thevinufernando/leo-floor-cleaning-robot/README.md

# leo-floor-cleaning-robot
An advanced Autonomous Floor Cleaning Robot.
