thevinufernando/leo-floor-cleaning-robot/docs/initial_basic_plan.jpeg

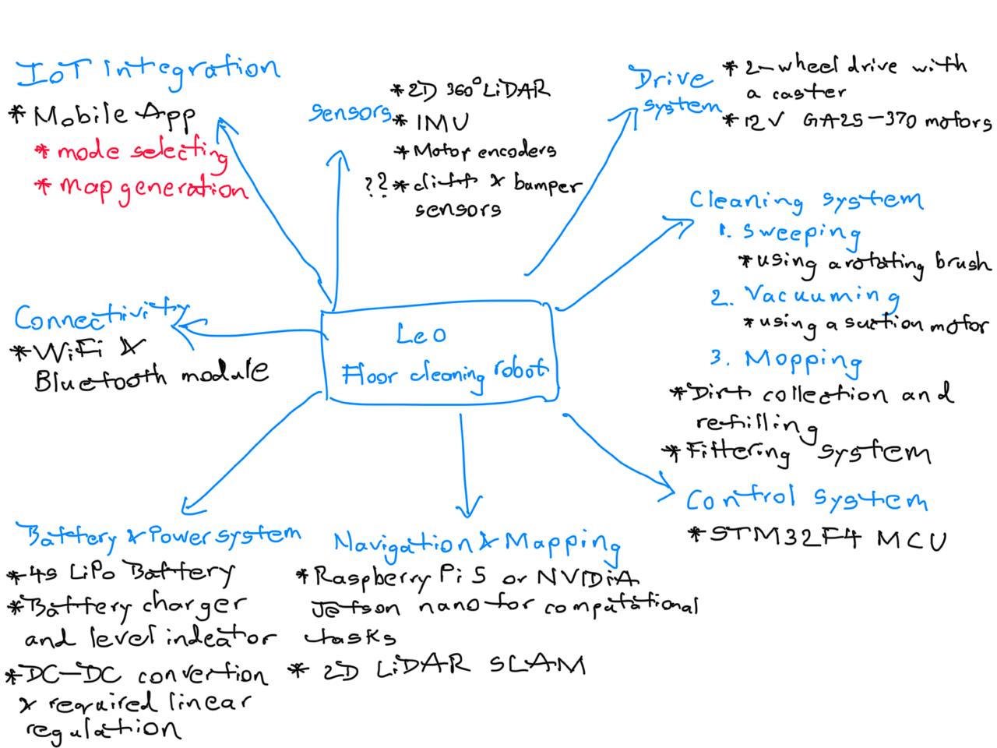
docs/initial_basic_plan.jpeg
