thevinufernando/leo-floor-cleaning-robot/Finalized design files/encloser split/topleft.STEP

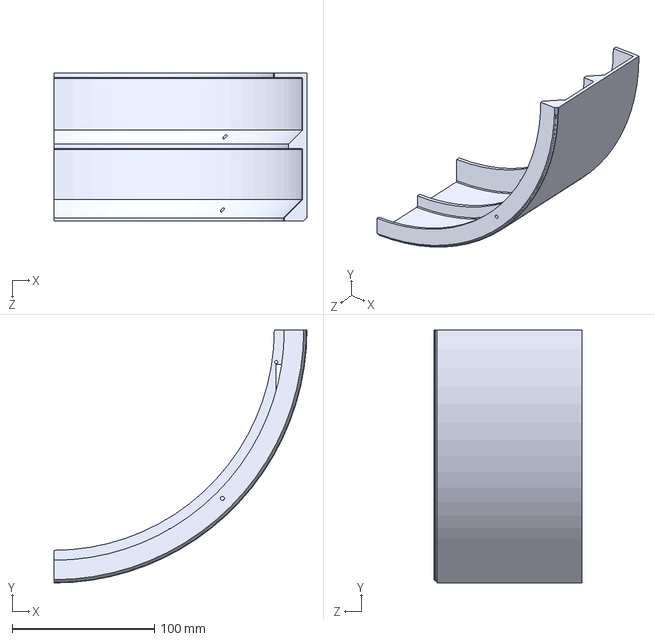
[picture p27: CAD file, 2026-08-20]
Finalized design files/encloser split/topleft.STEP
178.0 x 178.0 x 104.0 mm
