thevinufernando/leo-floor-cleaning-robot/Finalized design files/toplid ring.SLDPRT

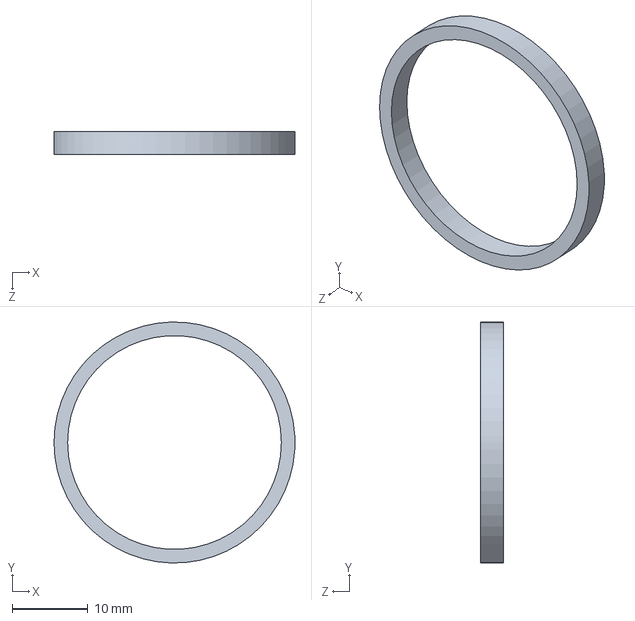
[picture p28: CAD file, 2026-08-20]
Finalized design files/toplid ring.SLDPRT
31.8 x 31.8 x 3.00 mm
