thevinufernando/leo-floor-cleaning-robot/mechanical_designs/Centrifugal Pump Design/Final Product Design/vaccum with base.step

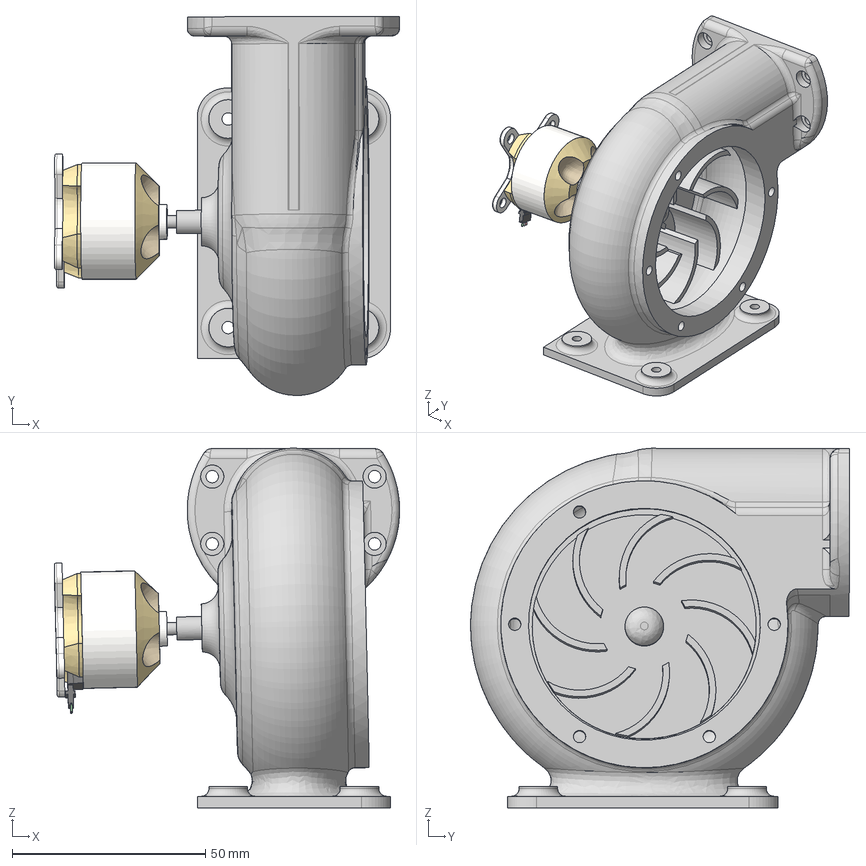
[picture p29: CAD file, 2026-08-04]
mechanical_designs/Centrifugal Pump Design/Final Product Design/vaccum with base.step
89.4 x 98.1 x 93.1 mm
Centrifugal_Pump_Case2
impeller_01
