thevinufernando/leo-floor-cleaning-robot/mechanical_designs/Centrifugal Pump Design/Pump Case Design/Centrifugal_Pump_Case2.SLDPRT

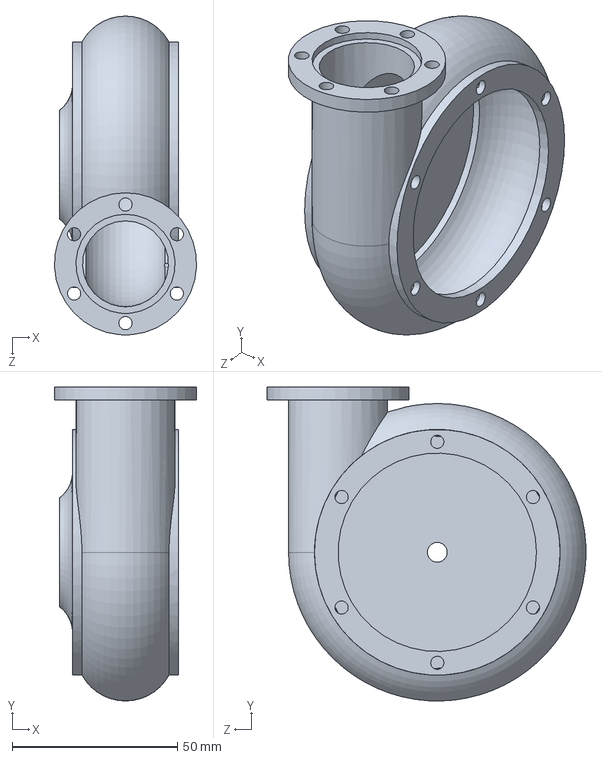
[picture p30: CAD file, 2026-08-06]
mechanical_designs/Centrifugal Pump Design/Pump Case Design/Centrifugal_Pump_Case2.SLDPRT
43.0 x 95.0 x 96.5 mm
