thevinufernando/leo-floor-cleaning-robot/mechanical_designs/Centrifugal Pump/impeller_01.SLDPRT

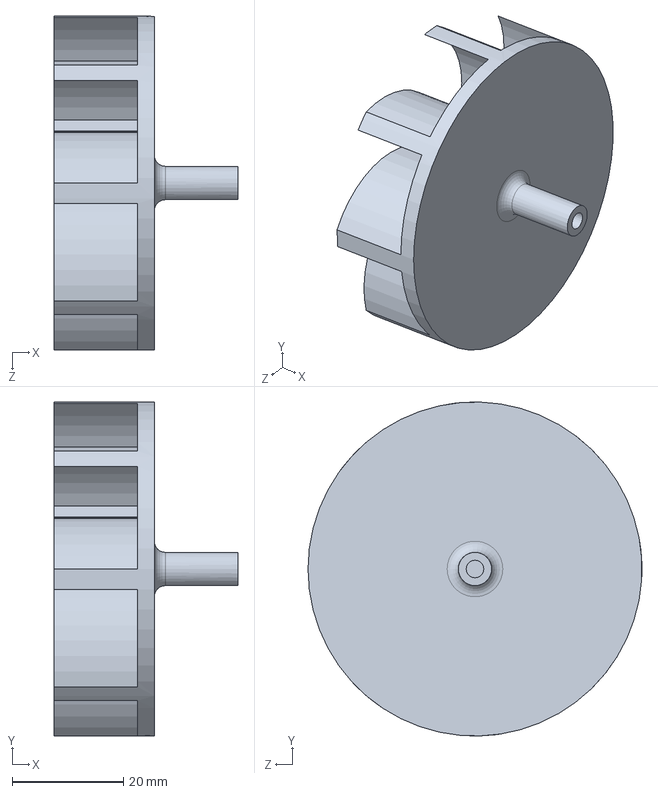
[picture p31: CAD file, 2026-08-04]
mechanical_designs/Centrifugal Pump/impeller_01.SLDPRT
33.0 x 60.0 x 60.0 mm
