thevinufernando/leo-floor-cleaning-robot/Finalized design files/air vent.SLDPRT

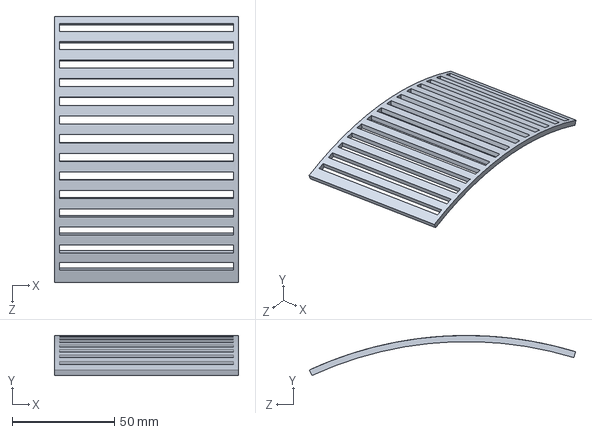
[picture p32: CAD file, 2026-08-20]
Finalized design files/air vent.SLDPRT
89.8 x 19.5 x 130.0 mm
