thevinufernando/leo-floor-cleaning-robot/Finalized design files/encloser split/topright.STEP

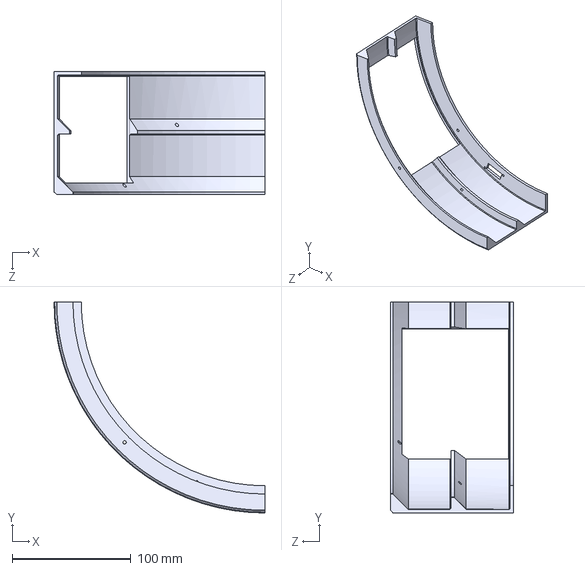
[picture p33: CAD file, 2026-08-20]
Finalized design files/encloser split/topright.STEP
178.0 x 178.0 x 104.0 mm
