thevinufernando/leo-floor-cleaning-robot/mechanical_designs/Centrifugal Pump Design/Pump Case Design/support.SLDPRT

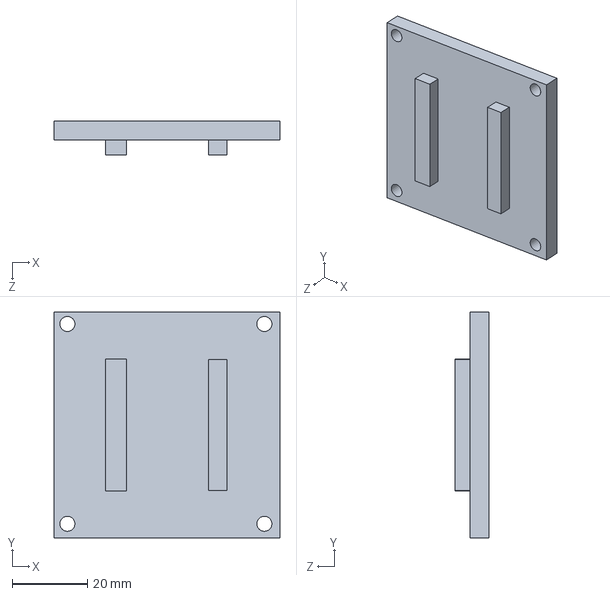
[picture p34: CAD file, 2026-08-06]
mechanical_designs/Centrifugal Pump Design/Pump Case Design/support.SLDPRT
60.0 x 60.0 x 9.00 mm
