thevinufernando/leo-floor-cleaning-robot/mechanical_designs/Centrifugal Pump/vaccum with impeller.STEP

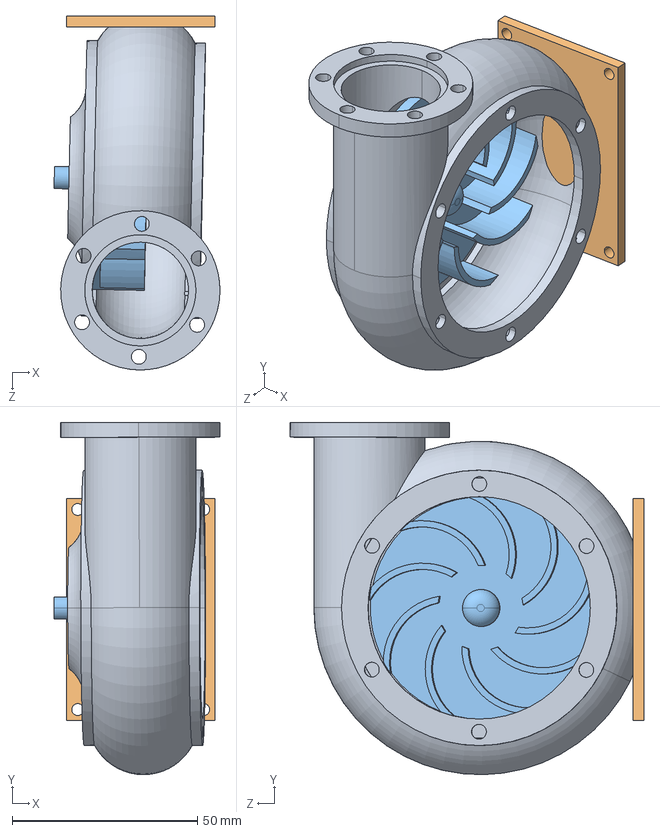
[picture p35: CAD file, 2026-08-04]
mechanical_designs/Centrifugal Pump/vaccum with impeller.STEP
44.8 x 95.1 x 95.5 mm
Centrifugal_Pump_Case2.step
vaccum.step
impeller_02_other blade direction
