thevinufernando/leo-floor-cleaning-robot/mechanical_designs/Centrifugal Pump Design/Pump Case Design/vaccum.STEP

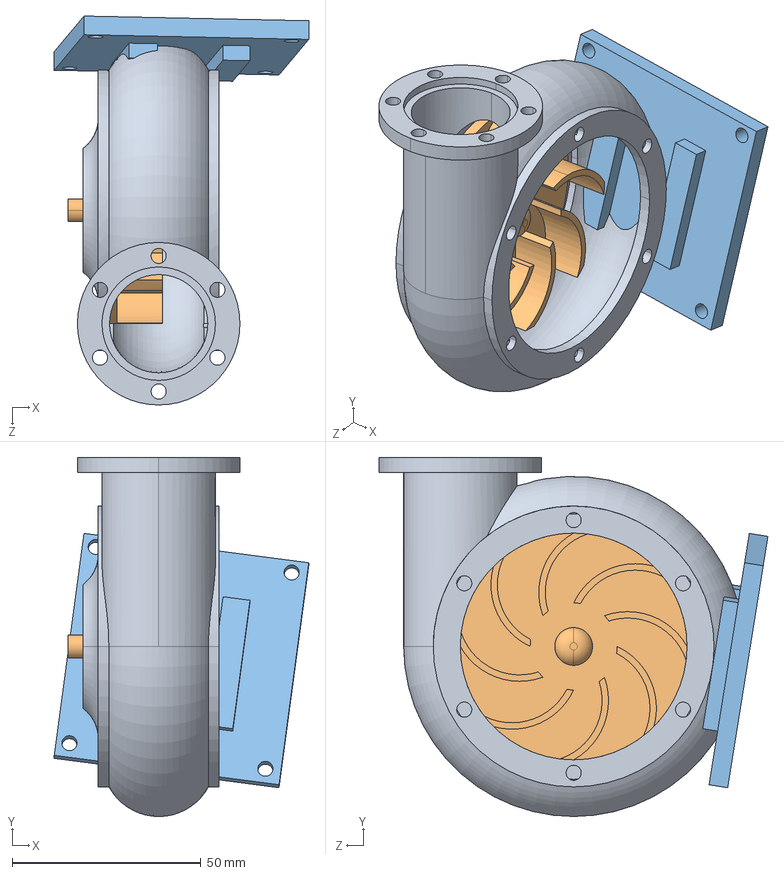
[picture p36: CAD file, 2026-08-06]
mechanical_designs/Centrifugal Pump Design/Pump Case Design/vaccum.STEP
67.4 x 95.0 x 102.9 mm
Centrifugal_Pump_Case2
impeller_01
support
