thevinufernando/leo-floor-cleaning-robot/mechanical_designs/Centrifugal Pump/impeller_02.SLDPRT

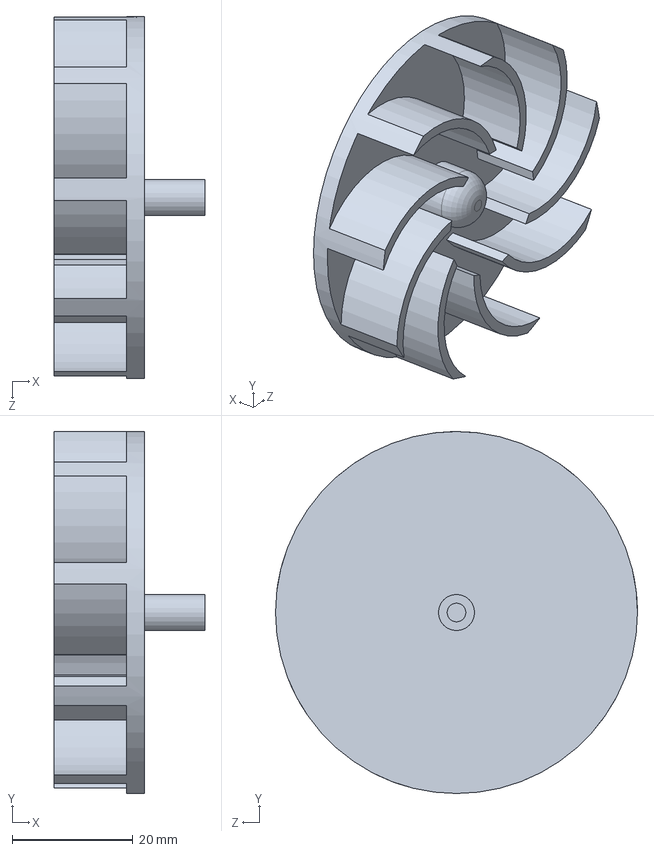
[picture p37: CAD file, 2026-08-04]
mechanical_designs/Centrifugal Pump/impeller_02.SLDPRT
25.0 x 60.0 x 60.0 mm
