thevinufernando/leo-floor-cleaning-robot/Finalized design files/encloser split/vacum and dustbin clip.STEP

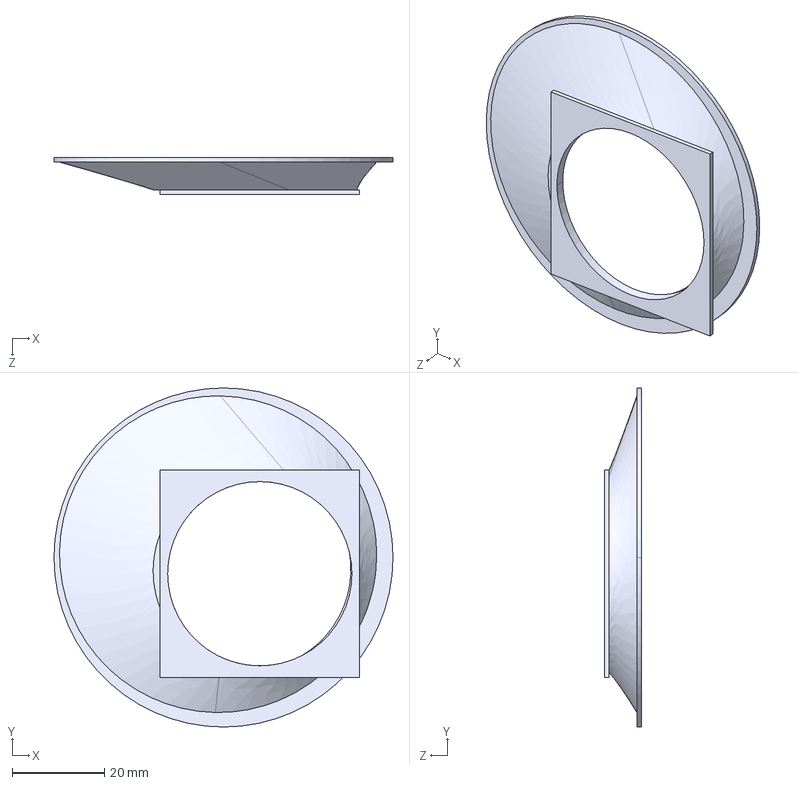
[picture p38: CAD file, 2026-08-20]
Finalized design files/encloser split/vacum and dustbin clip.STEP
73.6 x 73.6 x 8.00 mm
