thevinufernando/leo-floor-cleaning-robot/Finalized design files/encloser split/Sketch4.dxf

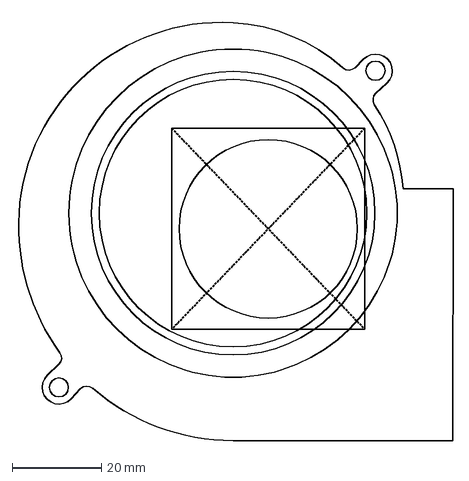
[picture p39: CAD file, 2026-08-20]
Finalized design files/encloser split/Sketch4.dxf
98.0 x 95.1 mm
