thevinufernando/leo-floor-cleaning-robot/Finalized design files/encloser split/vacum and dustbin clip3.STEP

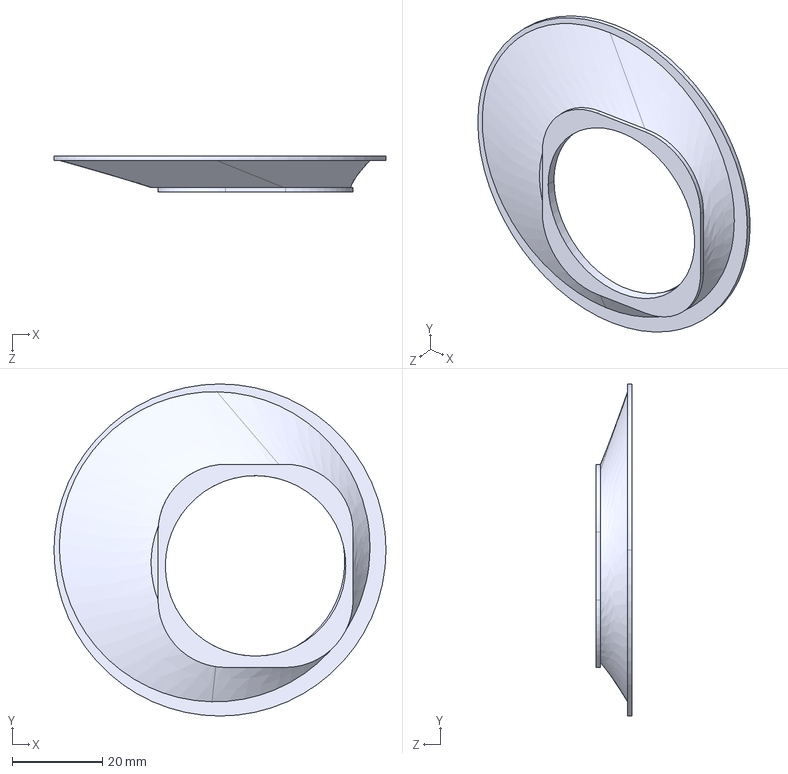
[picture p40: CAD file, 2026-08-20]
Finalized design files/encloser split/vacum and dustbin clip3.STEP
73.6 x 73.6 x 8.00 mm
