thevinufernando/leo-floor-cleaning-robot/Finalized design files/encloser split/vacum and dustbin clip2.STEP

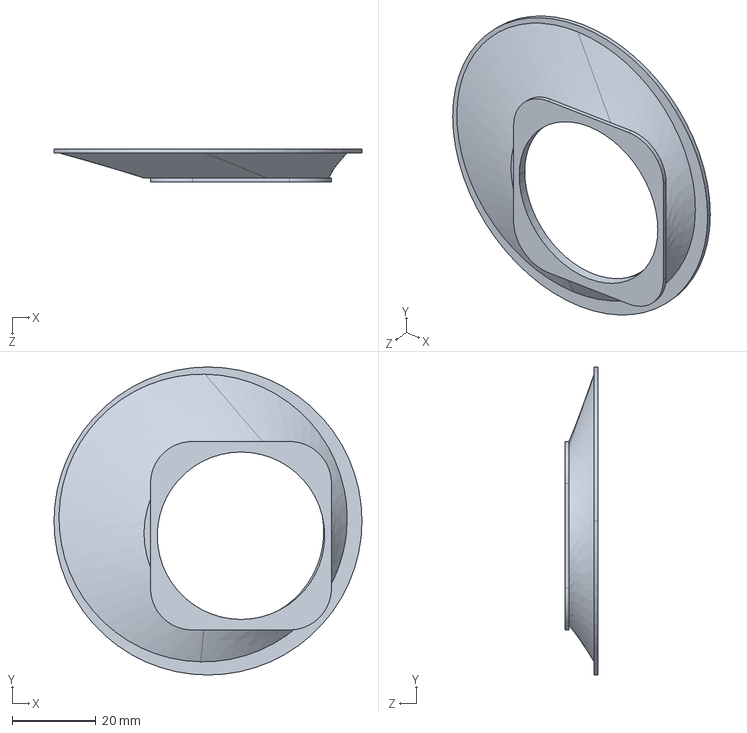
[picture p41: CAD file, 2026-08-20]
Finalized design files/encloser split/vacum and dustbin clip2.STEP
73.6 x 73.6 x 8.00 mm
