thevinufernando/leo-floor-cleaning-robot/mechanical_designs/Centrifugal Pump/vaccum with base with motor.SLDASM

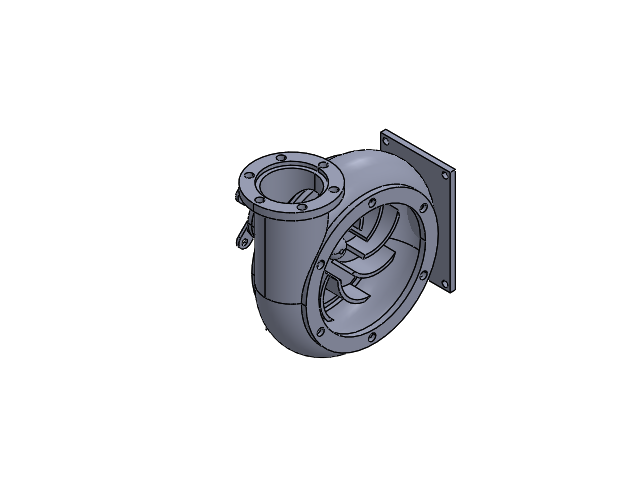
[picture p42: CAD file, 2026-08-04]
mechanical_designs/Centrifugal Pump/vaccum with base with motor.SLDASM
Centrifugal_Pump_Case2.step.STEP
vaccum.step.STEP
impeller_02_other blade direction.STEP
BLDC_A2212_13T_1000KV.STEP
BLDC_A2212_13T_1000KV_MountPlate.STEP
