thevinufernando/leo-floor-cleaning-robot/(list of files, cad)

Other CAD files:
Finalized design files/encloser split/Body8.SLDPRT
Finalized design files/encloser split/Body7.SLDPRT
Finalized design files/encloser split/Body6.SLDPRT
Finalized design files/encloser split/bottomleft.STEP
Finalized design files/encloser split/rightbottom.STEP
Finalized design files/encloser split/bottomleft.SLDPRT
Finalized design files/encloser split/rightbottom.SLDPRT
Finalized design files/encloser split/topleft.SLDPRT
Finalized design files/encloser split/topright.SLDPRT
Finalized design files/encloser split/vacum and dustbin clip.SLDPRT
mechanical_designs/Centrifugal Pump Design/Final Product Design/vaccum with base.iges
mechanical_designs/Centrifugal Pump Design/Pump Case Design/vaccum.SLDASM
