thevinufernando/leo-floor-cleaning-robot/pcb_designs/docs/TPS56637RPAR_5.1V_webench_reports/WBDesign7_Input Transient-3.pdf

## WEBENCH ® Design Report

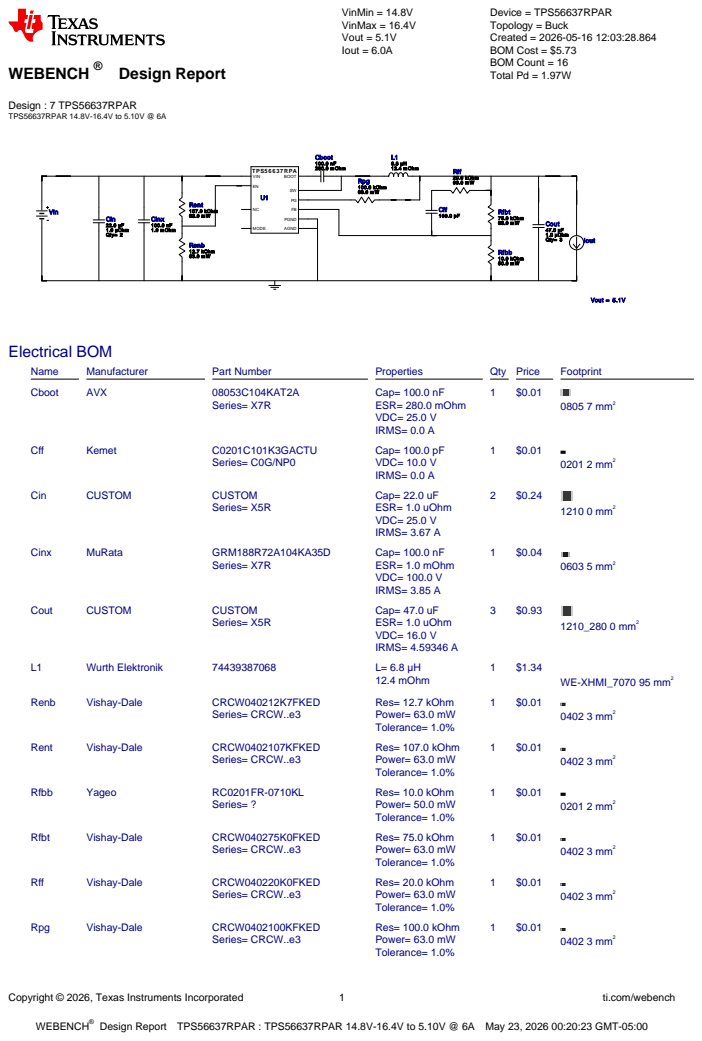
[picture p64: page 1]
Copyright © 2026, Texas Instruments Incorporated; ti.com/webench; WEBENCH®; Design : 7 TPS56637RPAR TPS56637RPAR 14.8V-16.4V to 5.10V @ 6A; VinMin = 14.8V VinMax = 16.4V Vout = 5.1V Iout = 6.0A; Device = TPS56637RPAR Topology = Buck Created = 2026-05-16 12:03:28.864 BOM Cost = $5.73 BOM Count = 16 Total Pd = 1.97W; Vout = 5.1V; Renb 12.7 kOhm 63.0 m W; Rent 107.0 kOhm 63.0 m W Cinx; 100.0 nF 1.0 m Ohm; TPS5 6 6 3 7 RPA; AGND; VIN; BOOT; PGND; MODE; Rpg 100.0 kOhm 63.0 m W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

Design Report TPS56637RPAR : TPS56637RPAR 14.8V-16.4V to 5.10V @ 6A May 23, 2026 00:20:23 GMT-05:00

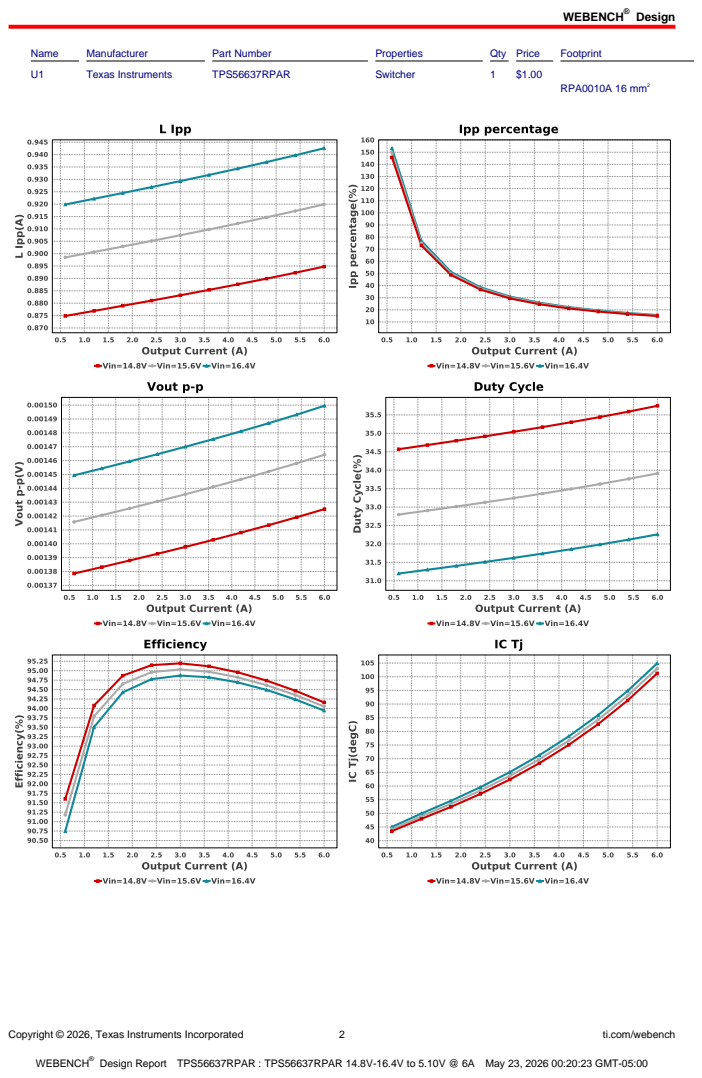
[picture p65: page 2]
Design; Copyright © 2026, Texas Instruments Incorporated; ti.com/webench; Name; Manufacturer; Part Number; Properties; Qty Price; Footprint; Texas Instruments; TPS56637RPAR; Switcher; RPA0010A 16 mm²

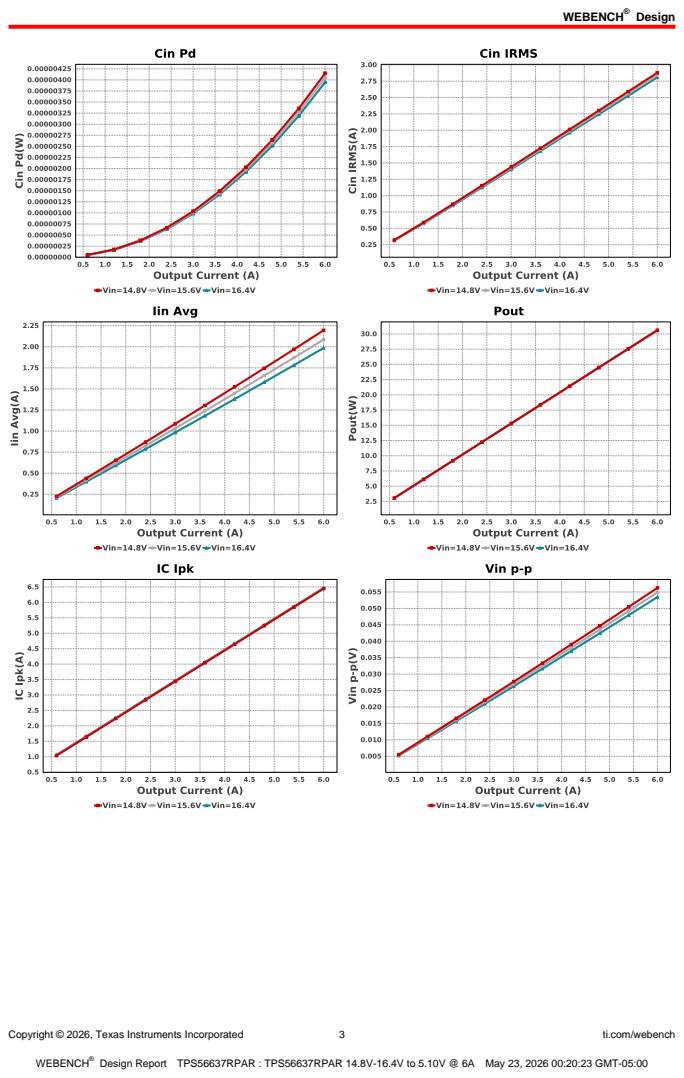
[picture p66: page 3]
Copyright © 2026, Texas Instruments Incorporated; ti.com/webench

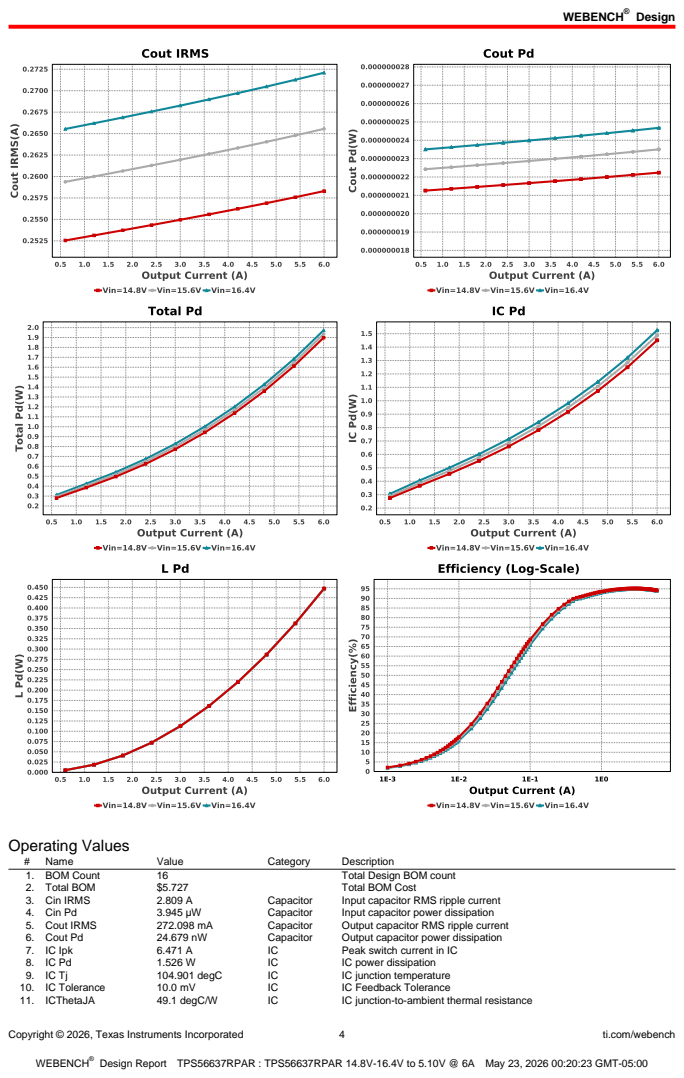
[picture p67: page 4]
Copyright © 2026, Texas Instruments Incorporated; ti.com/webench; Operating Values; Name; Value; Category; Description; 1. BOM Count; Total Design BOM count; 2. Total BOM; Total BOM Cost; 3. Cin IRMS; Capacitor; Input capacitor RMS ripple current; 4. Cin Pd; Input capacitor power dissipation; 5. Cout IRMS; Output capacitor RMS ripple current; 6. Cout Pd; Output capacitor power dissipation; 7. IC Ipk; Peak switch current in IC; IC power dissipation; 104.901 degC; IC junction temperature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

Copyright © 2026, Texas Instruments Incorporated | 5 | ti.com/webench
# | Name | Value | Category | Description

12. Iin Avg | 1.986 A | IC | Average input current
13. Ipp percentage | 15.71 % | Inductor | Inductor ripple current percentage (with respect to average inductor
| | | | current)
14. L Ipp | 942.574 mA | Inductor | Peak-to-peak inductor ripple current
15. L Pd | 447.32 mW | Inductor | Inductor power dissipation
16. Cin Pd | 3.945 µW | Power | Input capacitor power dissipation
17. Cout Pd | 24.679 nW | Power | Output capacitor power dissipation
18. IC Pd | 1.526 W | Power | IC power dissipation
19. L Pd | 447.32 mW | Power | Inductor power dissipation
20. Total Pd | 1.973 W | Power | Total Power Dissipation
21. Duty Cycle | 32.259 % | System
| | | Information | Duty cycle
22. Efficiency | 93.943 % | System
| | | Information | Steady state efficiency
23. FootPrint | 215.0 mm² | System
| | | Information | Total Foot Print Area of BOM components
24. Frequency | 557.247 kHz | System
| | | Information | Switching frequency
25. Iout | 6.0 A | System
| | | Information | Iout operating point
26. Mode | CCM | System
| | | Information | Conduction Mode
27. Pout | 30.6 W | System
| | | Information | Total output power
28. Vin | 16.4 V | System
| | | Information | Vin operating point
29. Vin p-p | 53.478 mV | System
| | | Information | Peak-to-peak input voltage
30. Vout | 5.1 V | System
| | | Information | Operational Output Voltage
31. Vout Actual | 5.1 V | System
| | | Information | Vout Actual calculated based on selected voltage divider resistors
32. Vout Tolerance | 3.479 % | System
| | | Information | Vout Tolerance based on IC Tolerance (no load) and voltage divider resistors if applicable
33. Vout p-p | 1.5 mV | System
| | | Information | Peak-to-peak output ripple voltage

## Design Inputs

Name | Value | Description
Iout | 6.0 | Maximum Output Current
VinMax | 16.4 | Maximum input voltage
VinMin | 14.8 | Minimum input voltage
Vout | 5.1 | Output Voltage
| base_pn | | TPS56637 | Base Product Number
source | DC | Input Source Type
Ta | 30.0 | Ambient temperature


Copyright © 2026, Texas Instruments Incorporated | 6 | ti.com/webench

## Assembly

## Component Testing

Some published data on components in datasheets such as Capacitor ESR and Inductor DC resistance is based on conservative values that will guarantee that the components always exceed the specification. For design purposes it is usually better to work with typical values. Since this data is not always available it is a good practice to measure the Capacitance and ESR values of Cin and Cout, and the inductance and DC resistance of L1 before assembly of the board. Any large discrepancies in values should be electrically simulated in WEBENCH to check for instabilities and thermally simulated in WebTHERM to make sure critical temperatures are not exceeded.

## Soldering Component to Board

If board assembly is done in house it is best to tack down one terminal of a component on the board then solder the other terminal. For surface mount parts with large tabs, such as the DPAK, the tab on the back of the package should be pre-tinned with solder, then tacked into place by one of the pins. To solder the tab town to the board place the iron down on the board while resting against the tab, heating both surfaces simultaneously. Apply light pressure to the top of the plastic case until the solder flows around the part and the part is flush with the PCB. If the solder is not flowing around the board you may need a higher wattage iron (generally 25W to 30W is enough).

## Initial Startup of Circuit

It is best to initially power up the board by setting the input supply voltage to the lowest operating input voltage 14.8V and set the input supply's current limit to zero. With the input supply off connect up the input supply to Vin and GND. Connect a digital volt meter and a load if needed to set the minimum Iout of the design from Vout and GND. Turn on the input supply and slowly turn up the current limit on the input supply.
If the voltage starts to rise on the input supply continue increasing the input supply current limit while watching the output voltage. If the current increases on the input supply, but the voltage remains near zero, then there may be a short or a component misplaced on the board. Power down the board and visually inspect for solder bridges and recheck the diode and capacitor polarities. Once the power supply circuit is operational then more extensive testing may include full load testing, transient load and line tests to compare with simulation results.

## Load Testing

The setup is the same as the initial startup, except that an additional digital voltmeter is connected between Vin and GND, a load is connected between Vout and GND and a current meter is connected in series between Vout and the load. The load must be able to handle at least rated output power + 50% ( 7.5 watts for this design). Ideally the load is supplied in the form of a variable load test unit. It can also be done in the form of suitably large power resistors. When using an oscilloscope to measure waveforms on the prototype board, the ground leads of the oscilloscope probes should be as short as possible and the area of the loop formed by the ground lead should be kept to a minimum. This will help reduce ground lead inductance and eliminate EMI noise that is not actually present in the circuit.

## WEBENCH® Electrical Simulation Report

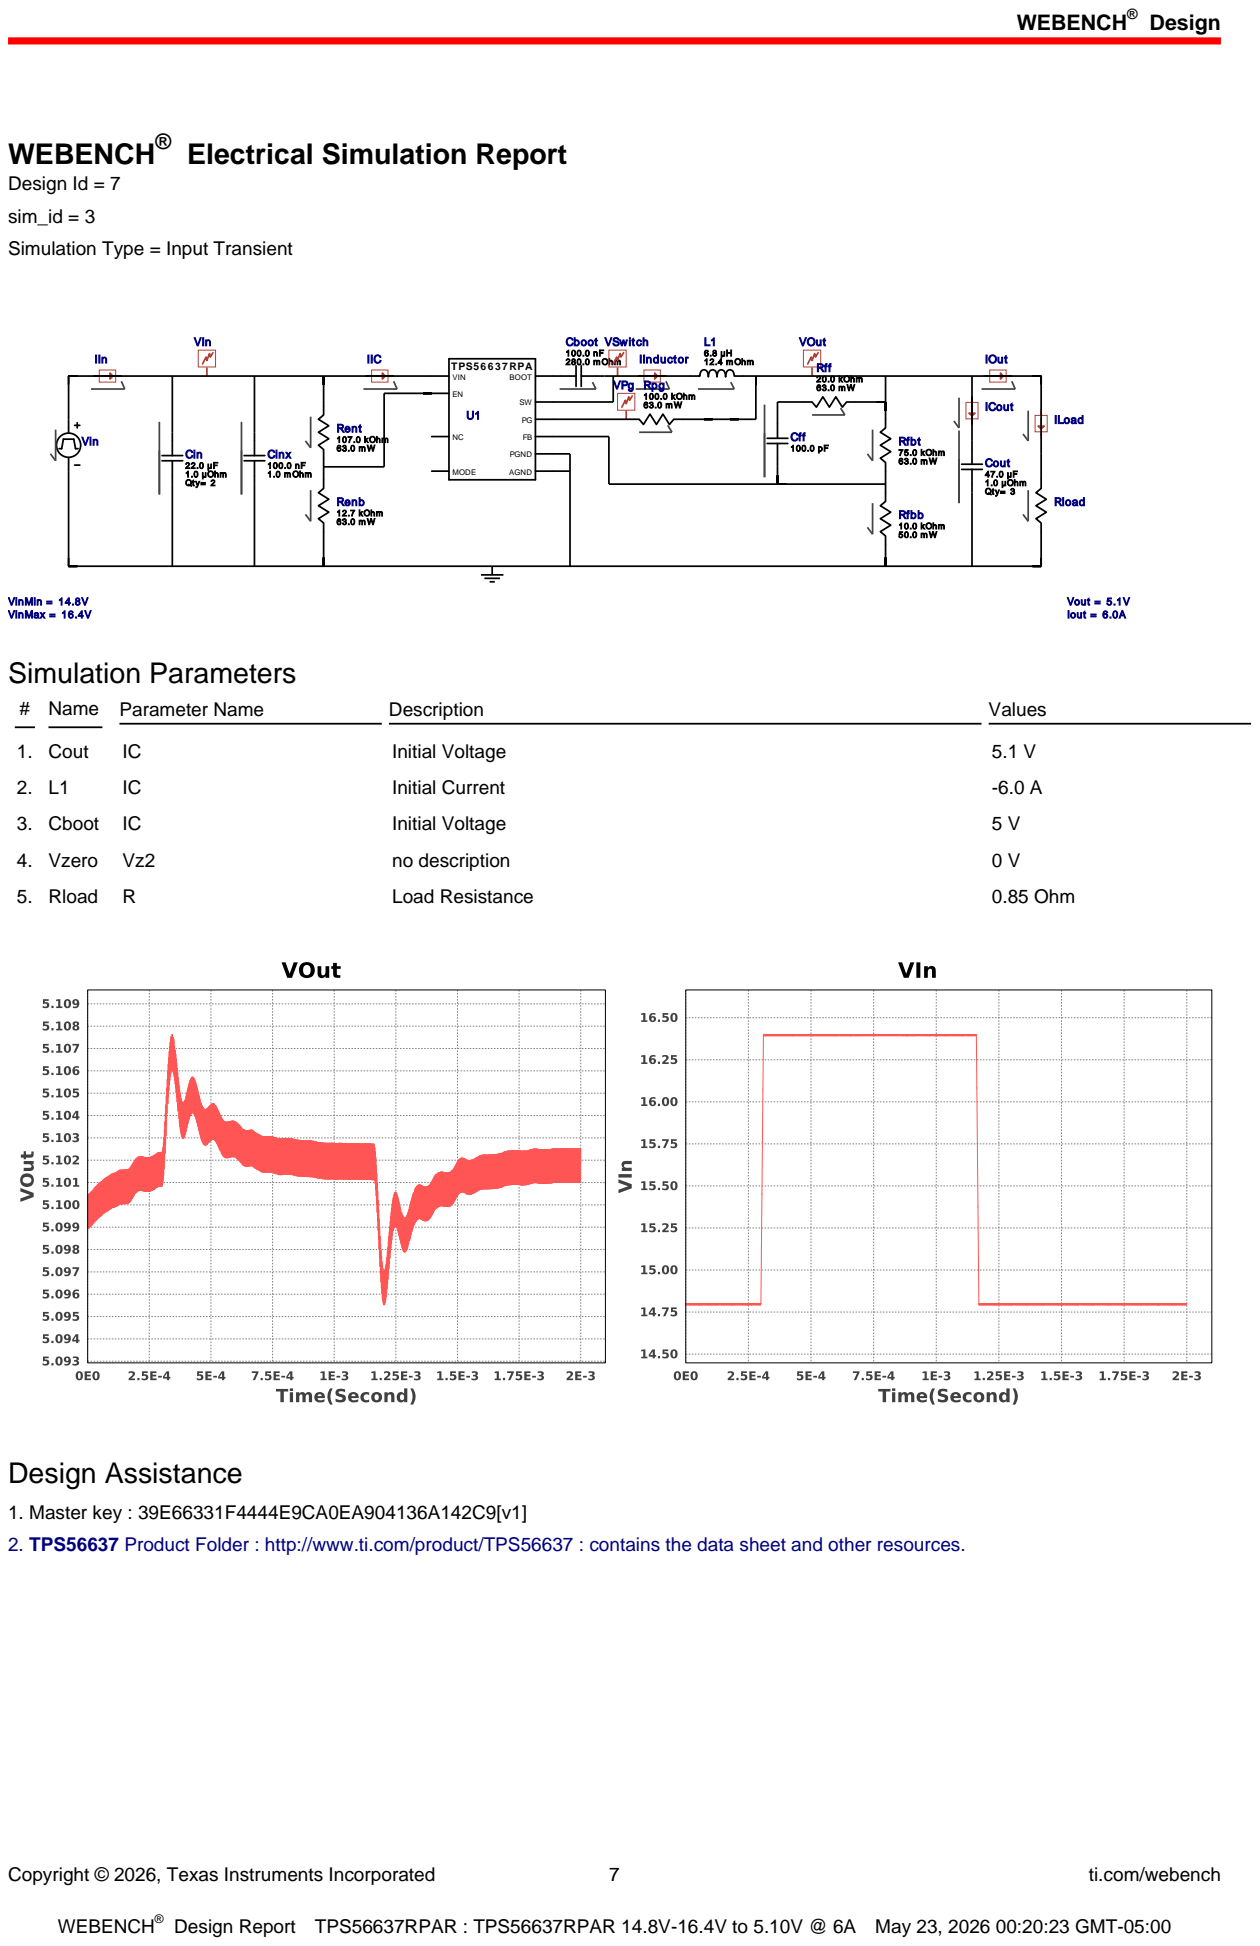
[picture p68: page 7]
Copyright © 2026, Texas Instruments Incorporated; ti.com/webench; IInductor; Vout = 5.1V Iout = 6.0A; VOut; IIC; Renb 12.7 kOhm 63.0 m W; Rent 107.0 kOhm 63.0 m W; VPg; Cinx 100.0 nF 1.0 m Ohm; TPS5 6 6 3 7 RPA; AGND; VIN; BOOT; PGND; MODE; Rpg 100.0 kOhm 63.0 m W; Cin 22.0 µF 1.0 µOhm Qty= 2; ICout; Cff 100.0 pF; Rff 20.0 kOhm 63.0 m W; VinMin = 14.8V VinMax = 16.4V; VIn; Cout 47.0 µF 1.0 µOhm Qty= 3; Rfbb 10.0 kOhm 50.0 m W; Rfbt 75.0 kOhm 63.0 m W; IIn; L1 6.8 µH 12.4 m Ohm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

Design Id = 7
sim_id = 3
Simulation Type = Input Transient

1. Master key : 39E66331F4444E9CA0EA904136A142C9[v1]
2. TPS56637 Product Folder : http://www.ti.com/product/TPS56637 : contains the data sheet and other resources.

Copyright © 2026, Texas Instruments Incorporated | 8 | ti.com/webench

Important Notice and Disclaimer

TI provides technical and reliability data (including datasheets), design resources (including reference designs), application or other design advice, web tools, safety information, and other resources AS IS and with all faults, and disclaims all warranties. These resources are intended for skilled developers designing with TI products. You are solely responsible for (1) selecting the appropriate TI products for your application, (2) designing, validating and testing your application, and (3) ensuring your application meets applicable standards, and any other safety, security, or other requirements.

These resources are subject to change without notice. TI grants you permission to use these resources only for development of an application that uses the TI products described in the resource. Other reproduction and display of these resources is prohibited. No license is granted to any other TI intellectual property right or to any third party intellectual property right. TI disclaims responsibility for, and you will fully indemnify TI and its representatives against, any claims, damages, costs, losses, and liabilities arising out of your use of these resources.

Providing these resources does not expand or otherwise alter TI's applicable Terms of Sale or other applicable terms available either on ti.com or provided in conjunction with TI products.
