thevinufernando/leo-floor-cleaning-robot/pcb_designs/leo_PCB/schematics/sch_pdfs/leo_schs.pdf

A A

1

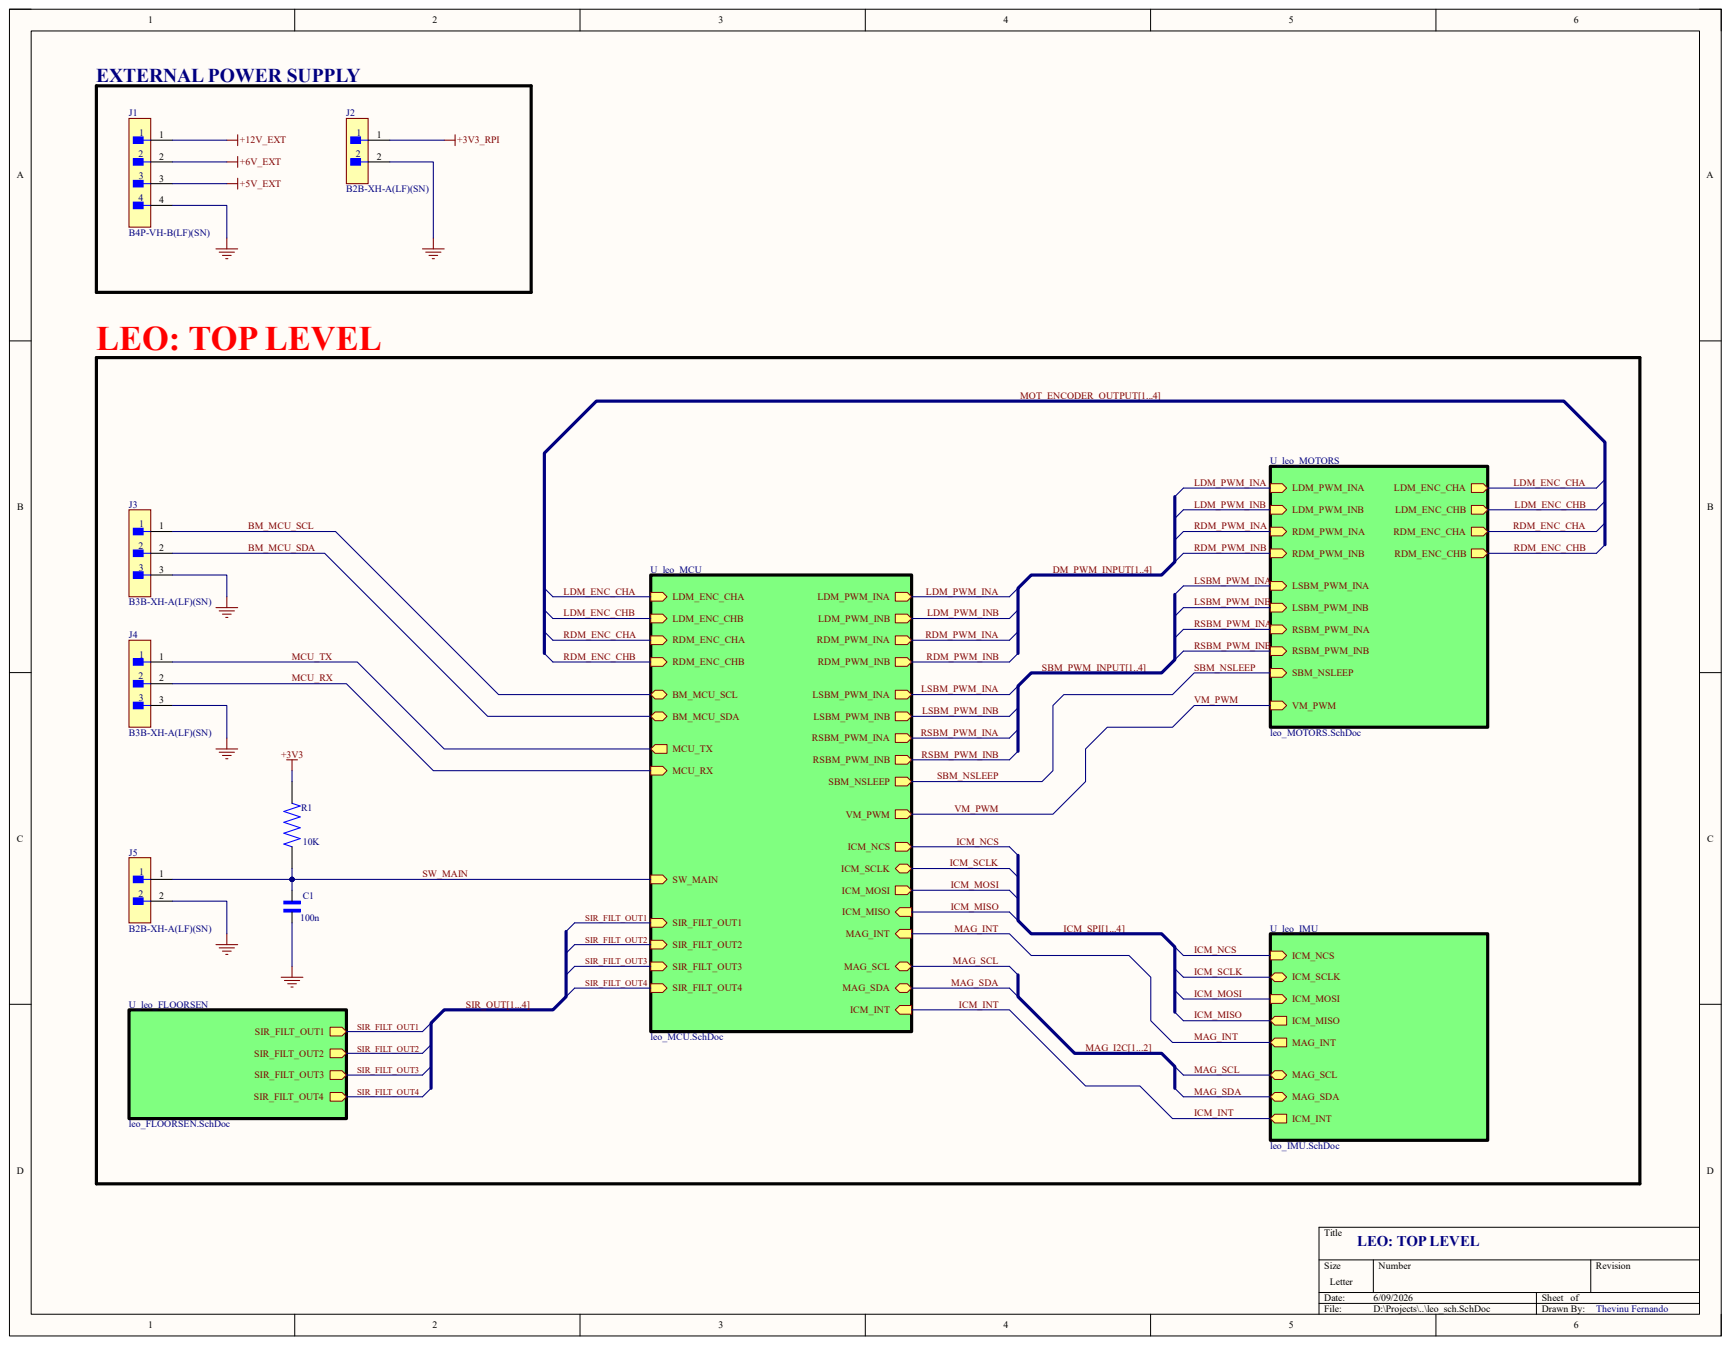
[picture p84: page 1]
Size; Number; Revision; Letter; Date:; Sheet of; File:; D:\Projects\..\leo_sch.SchDoc; Drawn By:; ICM_NCS; ICM_SCLK; ICM_MISO; ICM_MOSI; MAG_SCL; MAG_SDA; RDM_PWM_INA; RDM_PWM_INB; LDM_PWM_INA; LDM_PWM_INB; RDM_ENC_CHA; RDM_ENC_CHB; LDM_ENC_CHA; LDM_ENC_CHB; RSBM_PWM_INA; RSBM_PWM_INB; LSBM_PWM_INA; LSBM_PWM_INB; VM_PWM; SIR_FILT_OUT1; SIR_FILT_OUT2; SIR_FILT_OUT3; SIR_FILT_OUT4; BM_MCU_SCL; BM_MCU_SDA; MCU_TX; MCU_RX; SW_MAIN; SBM_NSLEEP; ICM_INT; MAG_INT; U_leo_MCU; leo_MCU.SchDoc; +12V_EXT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

EXTERNAL POWER SUPPLY

LEO: TOP LEVEL

Title

# USB 2.0 USB Type-C CONNECTOR

5V to 3.3V REGULATOR | POWER SELECTORS

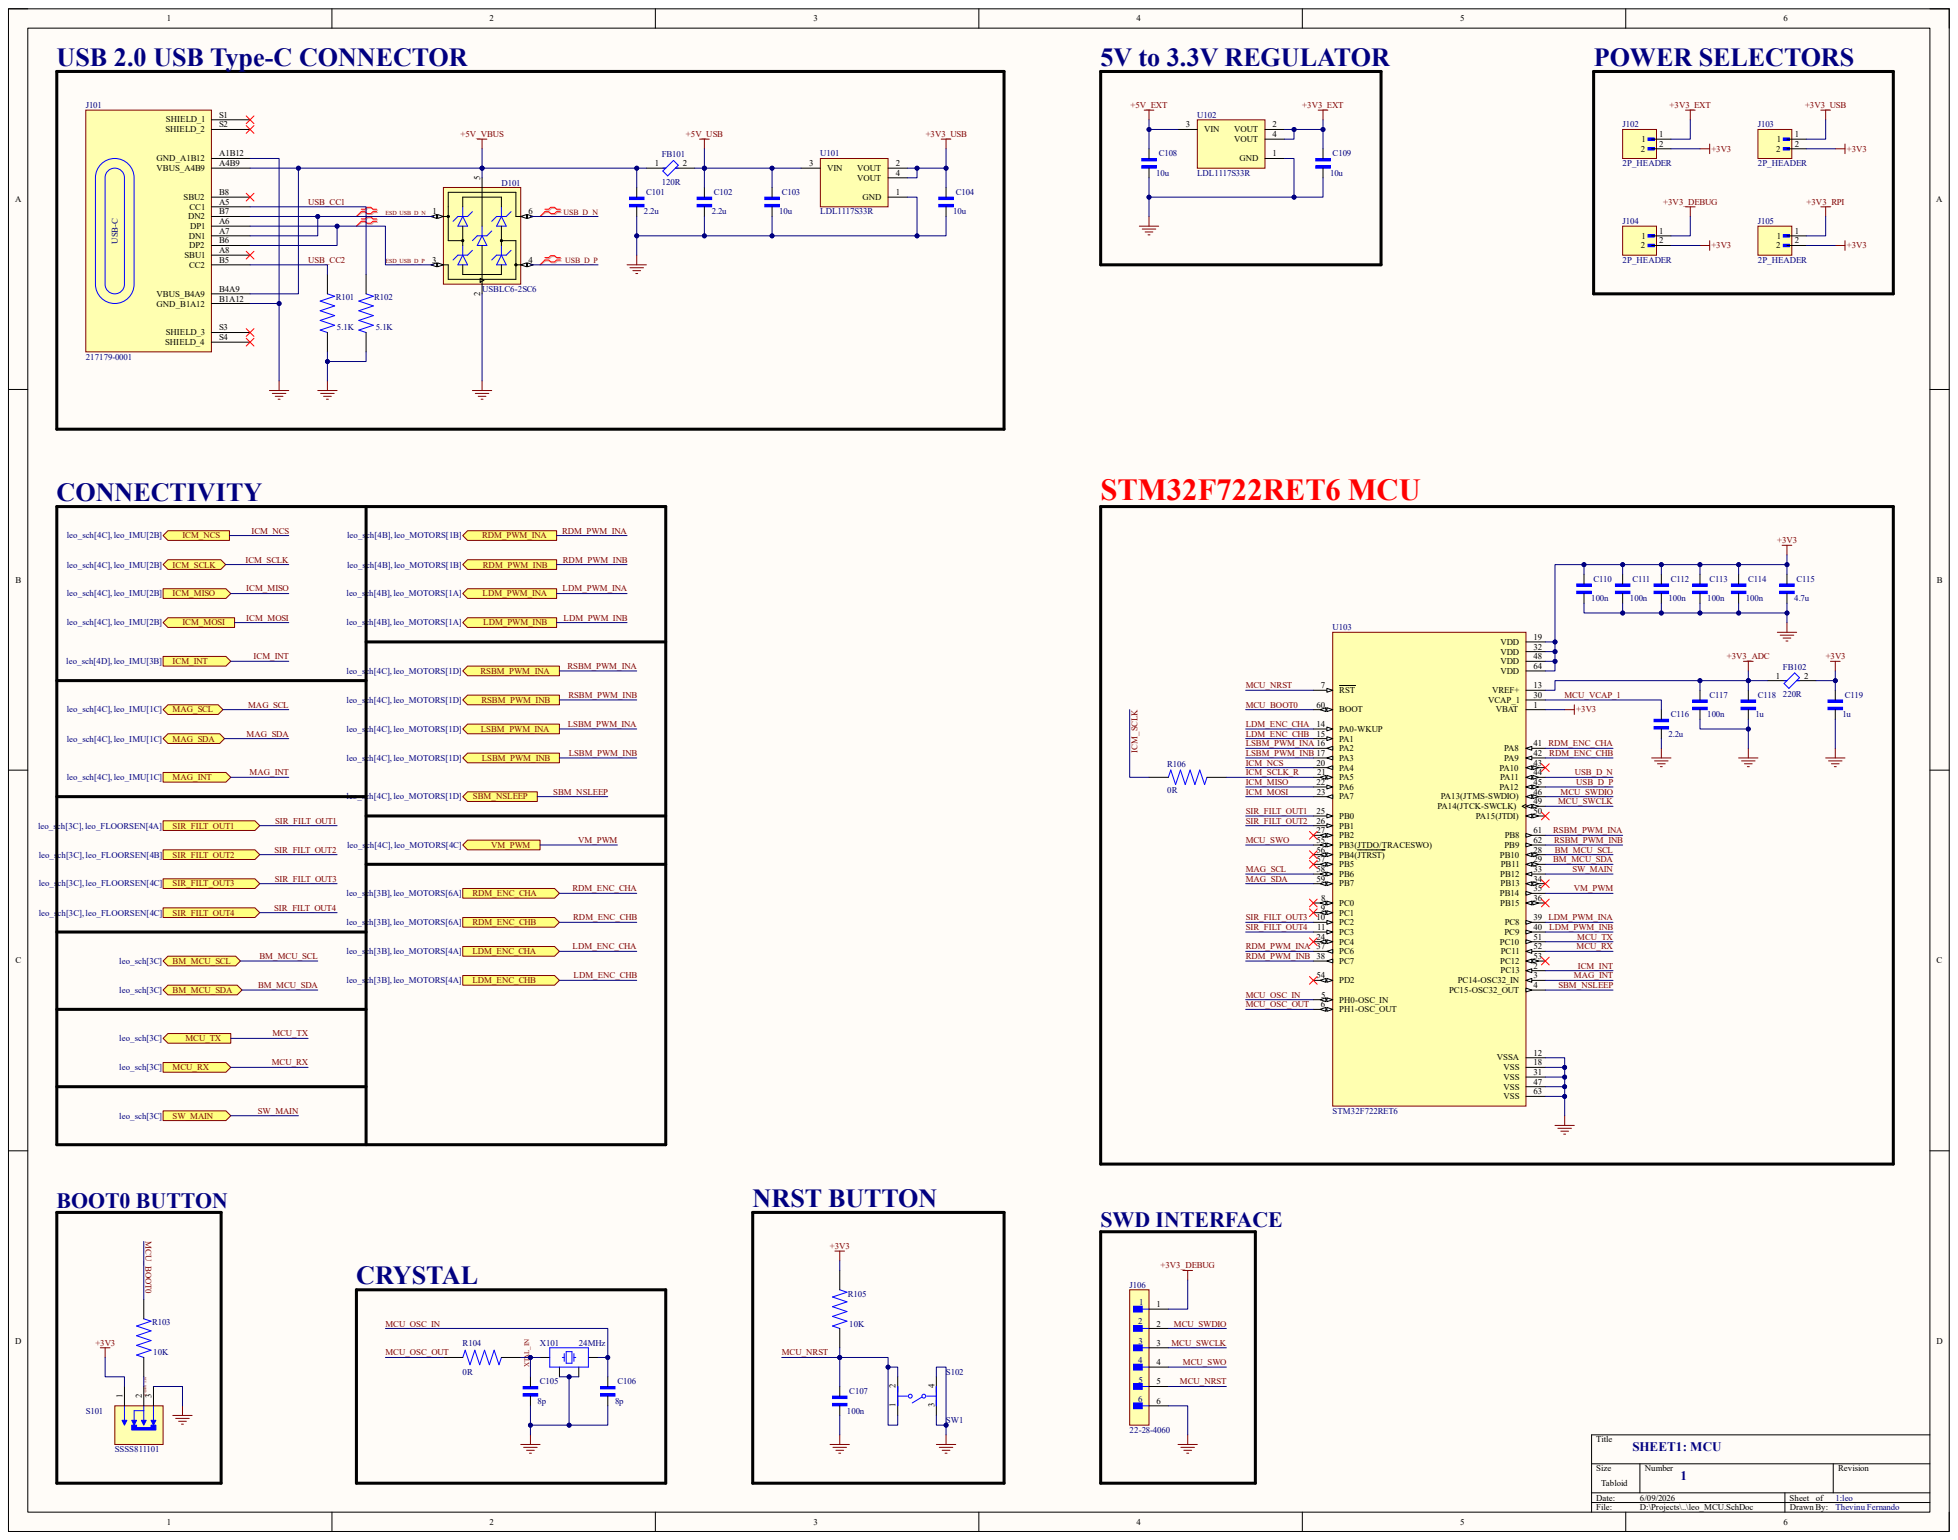
[picture p85: page 2]

1

2

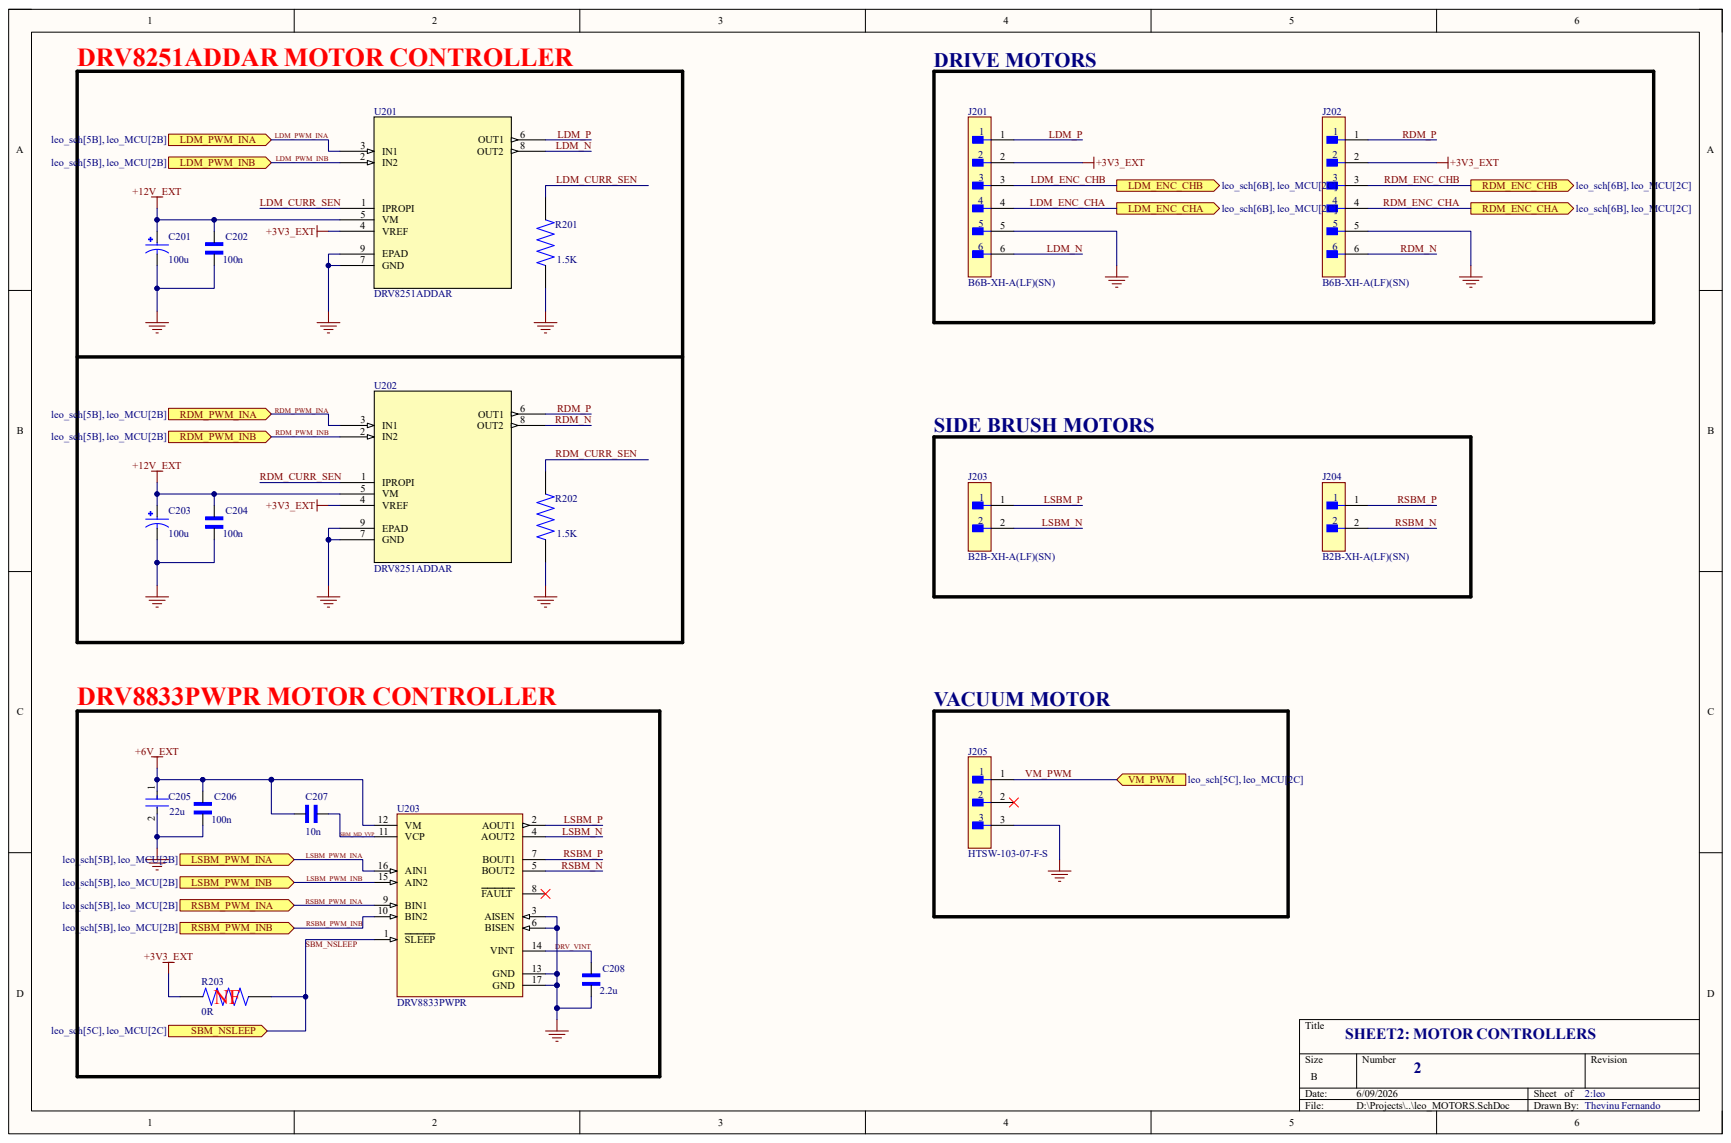
[picture p86: page 3]

A A

U301

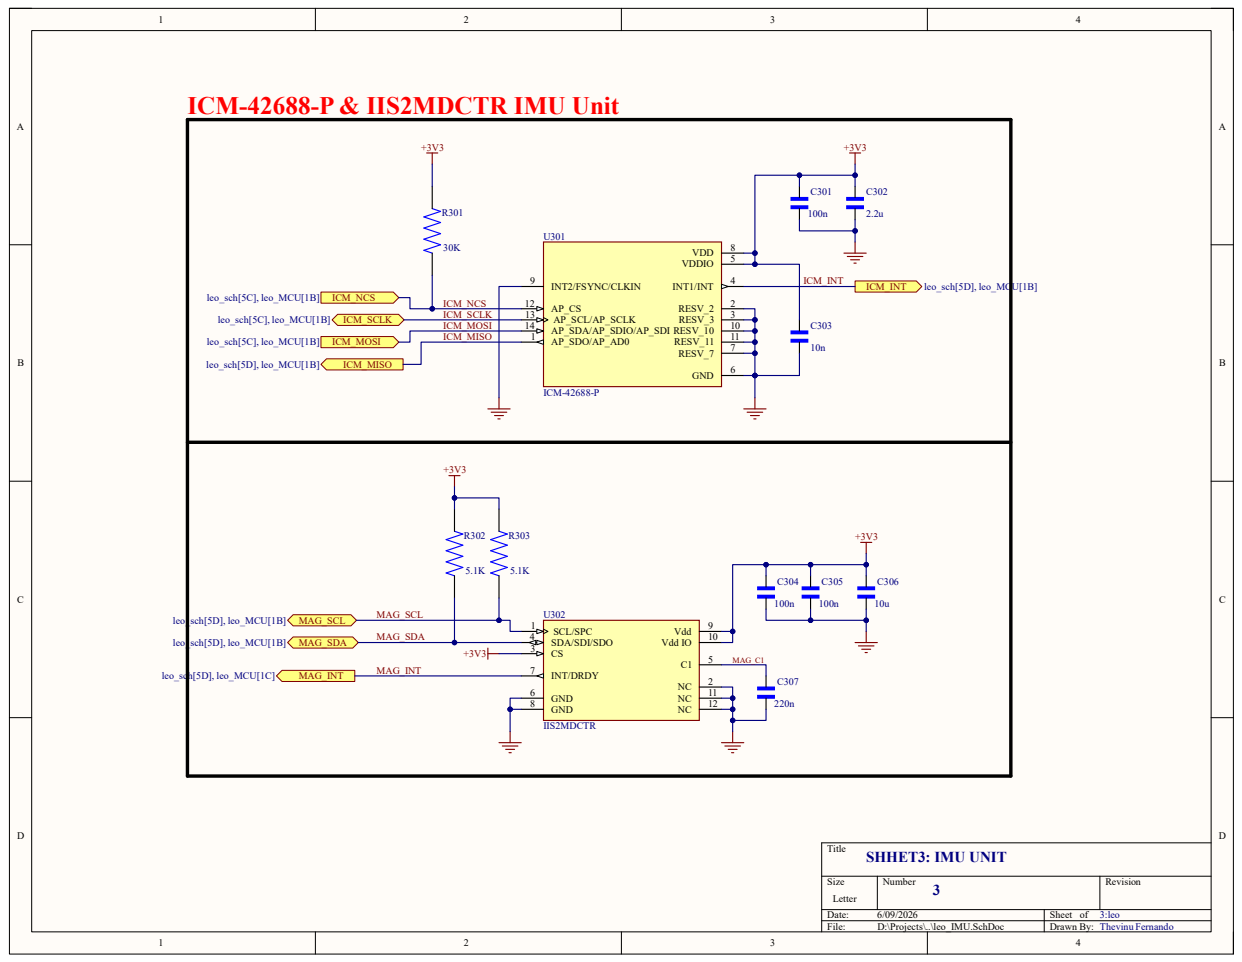
[picture p87: page 4]

A A
1

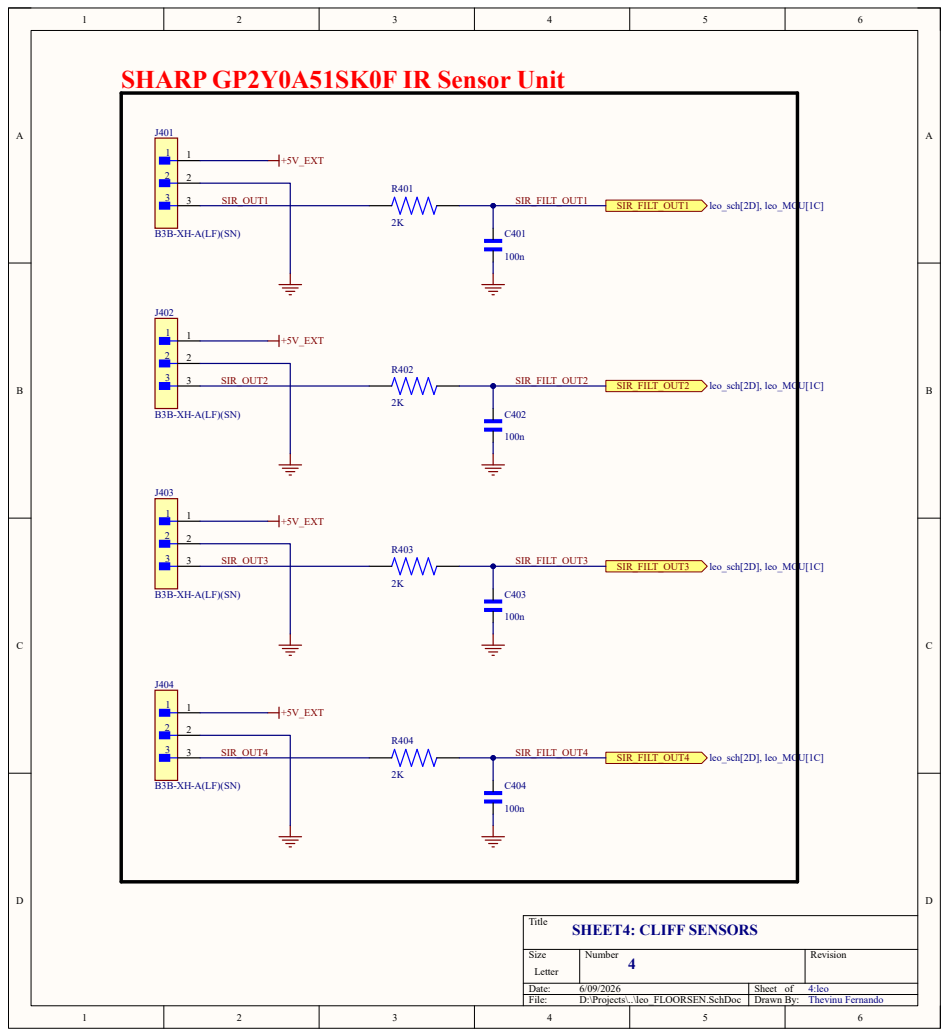
[picture p88: page 5]

SHARP GP2Y0A51SK0F IR Sensor Unit
