thevinufernando/leo-floor-cleaning-robot/pcb_designs/leo_POWER/schematics/sch_pdfs/leo_power_schs.pdf

A A

## POS 1

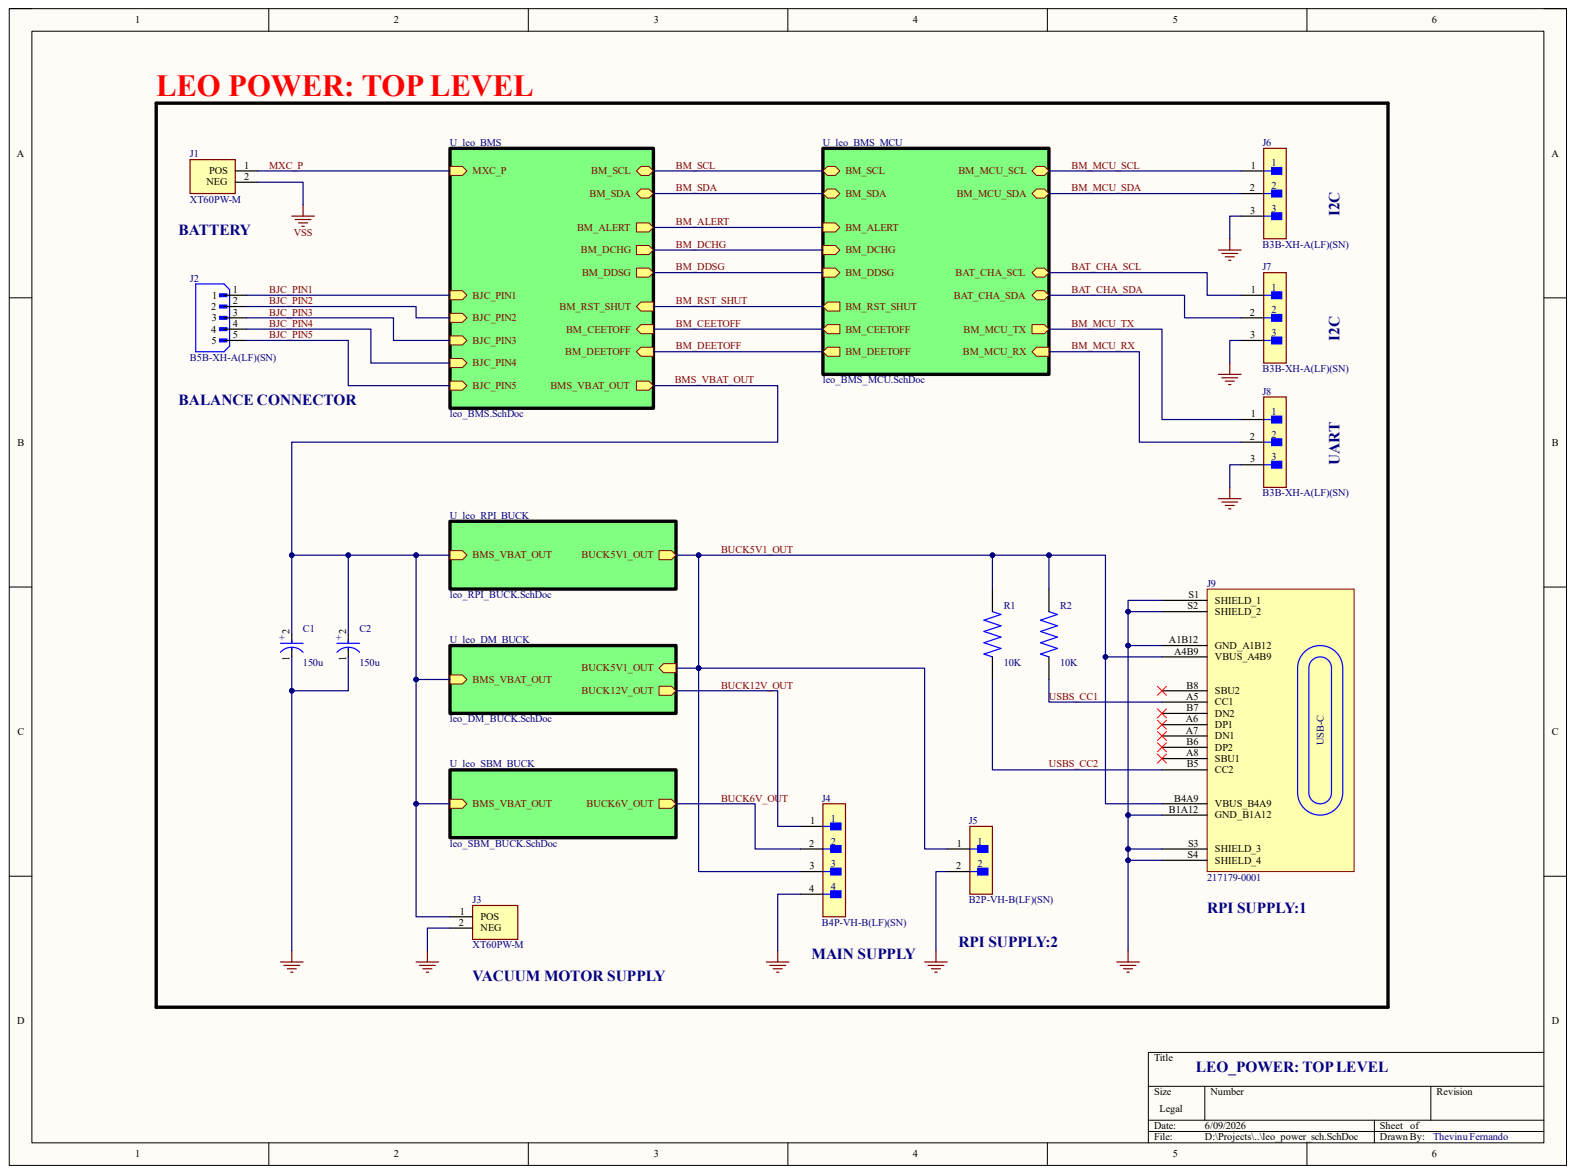
[picture p89: page 1]

LEO POWER: TOP LEVEL

A A

100u BMS_VBAT_OUT leo_power_sch[2C], leo_BMS[6A], leo_ | BUCK⁶V_OUT leo_power_sch[3C] BUCK6V_OUT BMS_VBAT_OUT

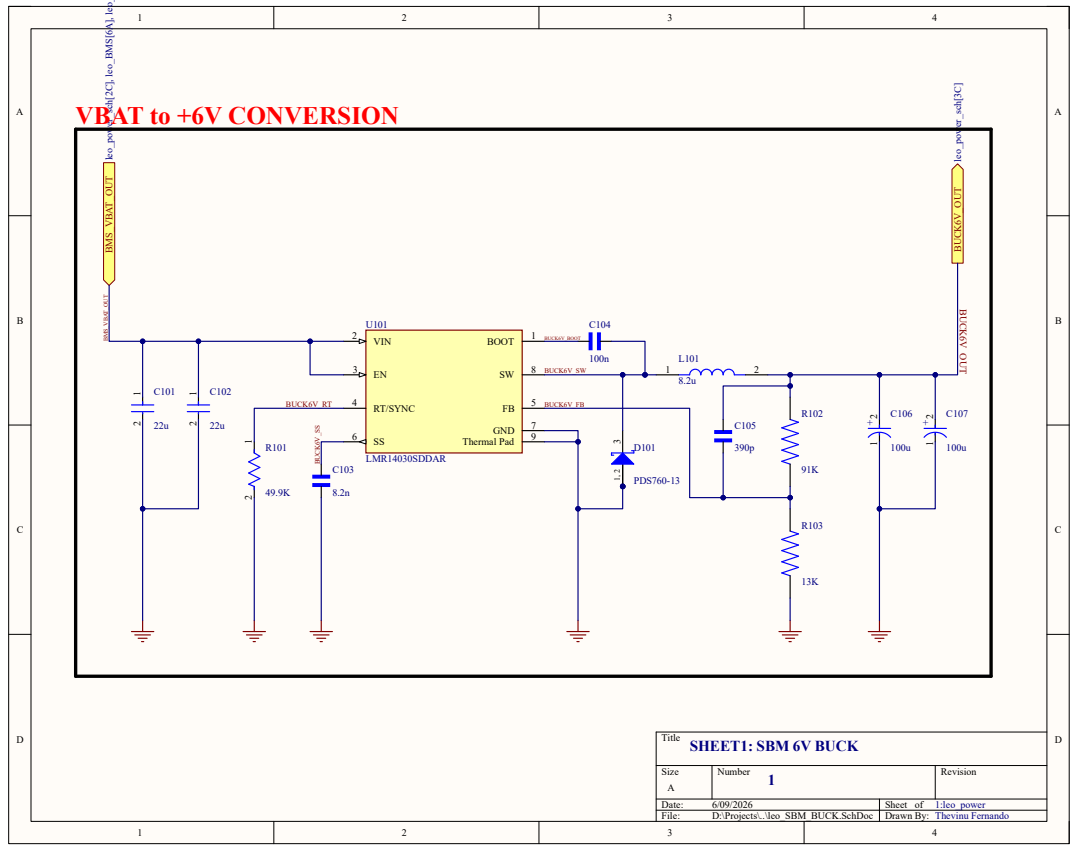
[picture p90: page 2]

A A

# VBAT to +12V CONVERSION

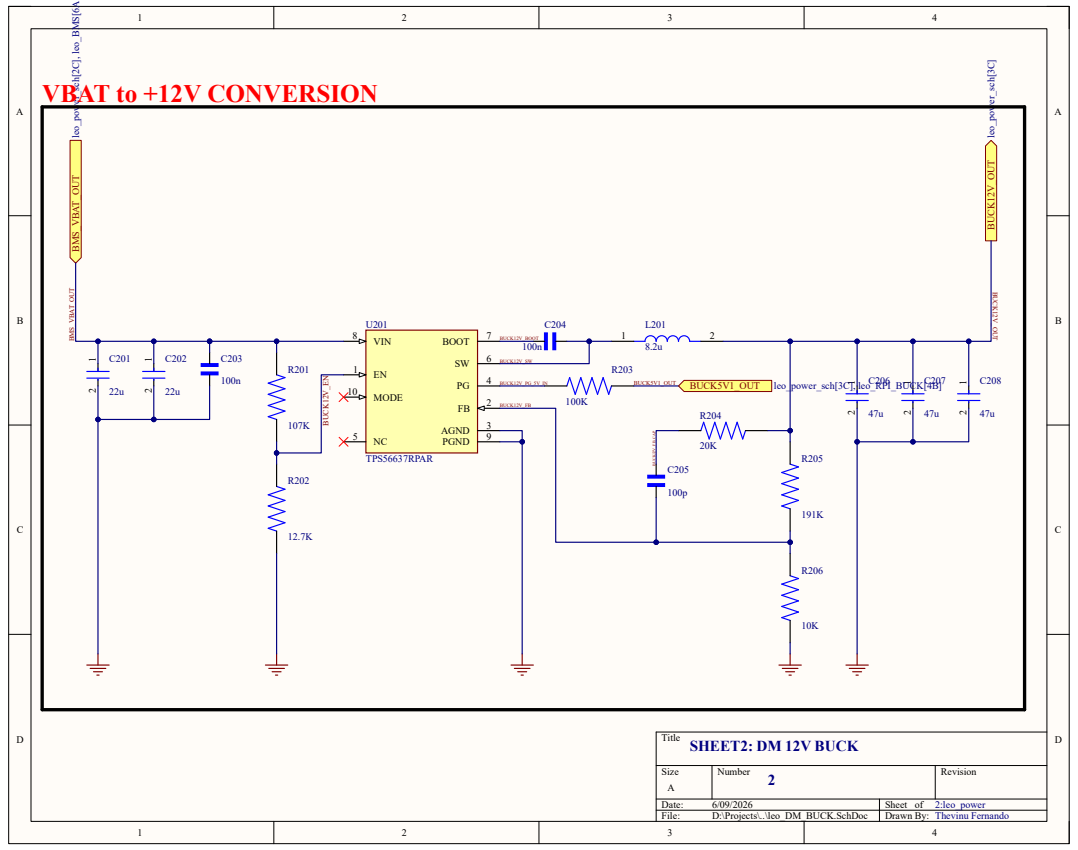
[picture p91: page 3]

A A

# VBAT to +5.1V CONVERSION

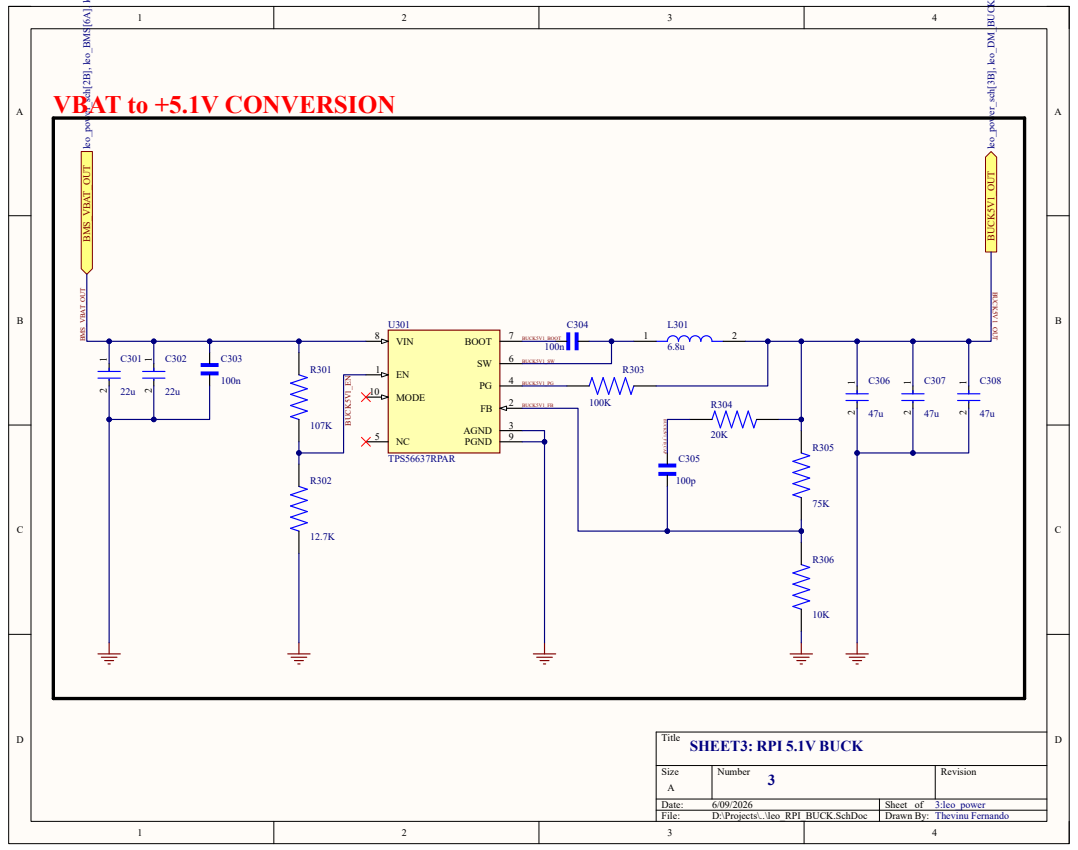
[picture p92: page 4]

# HIGH SIDE FET PROTECTION

# POWER CONNECTIVITY

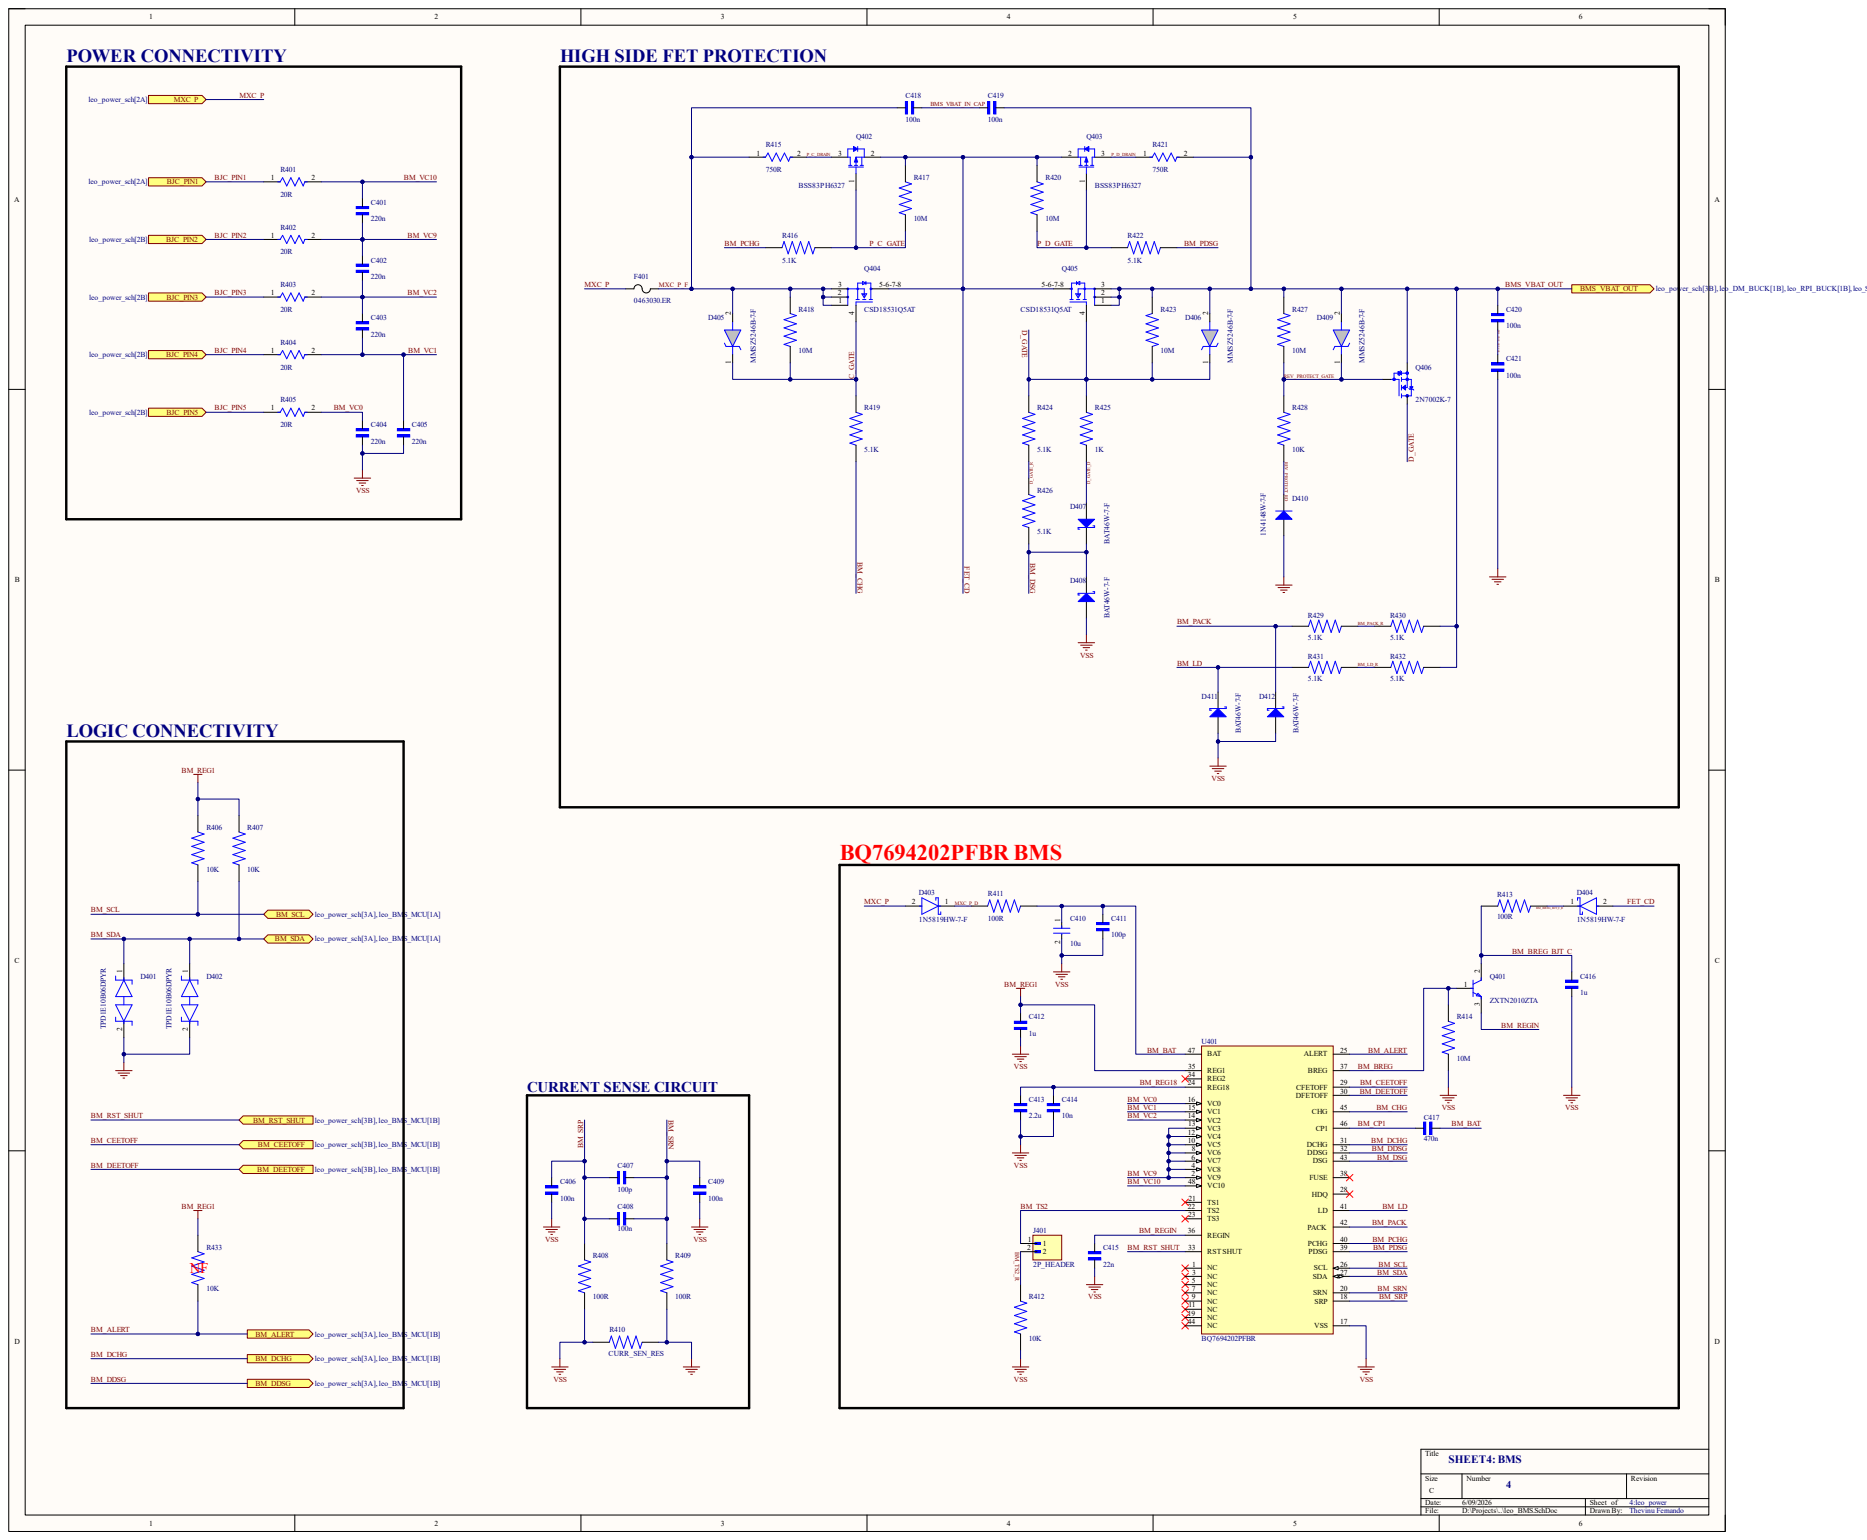
[picture p93: page 5]

A A

## RST 7

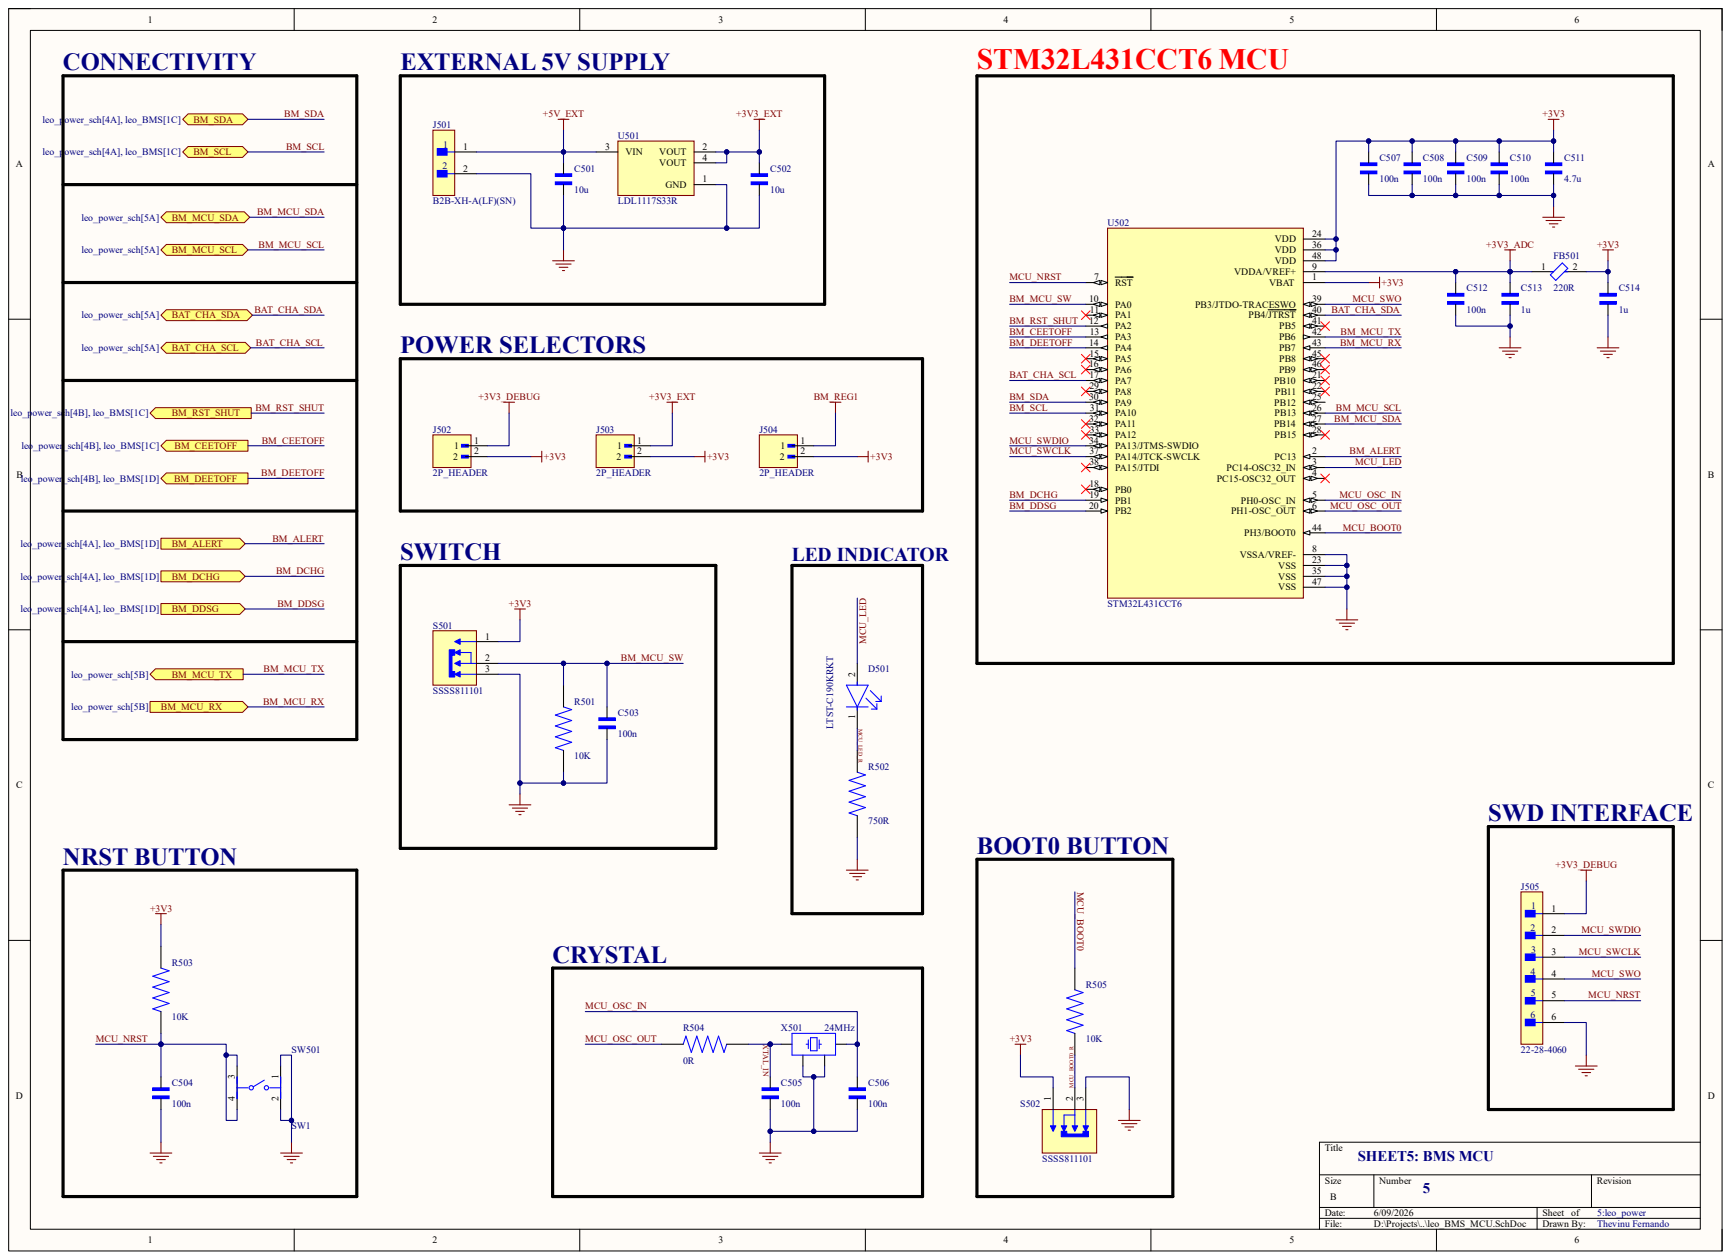
[picture p94: page 6]
