thevinufernando/leo-floor-cleaning-robot/(list of files, drawings)

Other design files:
pcb_designs/leo_PCB/pcb_files/leo_pcb.PcbDoc
pcb_designs/leo_PCB/schematics/leo_FLOORSEN.SchDoc
pcb_designs/leo_PCB/schematics/leo_IMU.SchDoc
pcb_designs/leo_PCB/schematics/leo_MCU.SchDoc
pcb_designs/leo_PCB/schematics/leo_MOTORS.SchDoc
pcb_designs/leo_PCB/schematics/leo_sch.SchDoc
pcb_designs/leo_POWER/pcb_files/leo_power_pcb.PcbDoc
pcb_designs/leo_POWER/schematics/leo_BMS.SchDoc
pcb_designs/leo_POWER/schematics/leo_BMS_MCU.SchDoc
pcb_designs/leo_POWER/schematics/leo_DM_BUCK.SchDoc
pcb_designs/leo_POWER/schematics/leo_power_sch.SchDoc
pcb_designs/leo_POWER/schematics/leo_RPI_BUCK.SchDoc
pcb_designs/leo_POWER/schematics/leo_SBM_BUCK.SchDoc
