thevinufernando/leo-floor-cleaning-robot/mcu_firmware/main_controller/main_controller.ioc

Mcu.UserName=STM32F722RETx
PA0-WKUP.GPIO_Label=LDM_ENC_CHA
PA0-WKUP.Signal=S_TIM2_CH1_ETR
PA1.GPIO_Label=LDM_ENC_CHB
PA1.Signal=S_TIM2_CH2
PA11.Signal=USB_OTG_FS_DM
PA12.Signal=USB_OTG_FS_DP
PA13.Signal=SYS_JTMS-SWDIO
PA14.Signal=SYS_JTCK-SWCLK
PA4.GPIO_Label=ICM_NCS
PA4.Signal=GPIO_Output
PA5.GPIO_Label=ICM_SCLK
PA5.Signal=SPI1_SCK
PA6.GPIO_Label=ICM_MISO
PA6.Signal=SPI1_MISO
PA7.GPIO_Label=ICM_MOSI
PA7.Signal=SPI1_MOSI
PA8.GPIO_Label=RDM_ENC_CHA
PA8.Signal=S_TIM1_CH1
PA9.GPIO_Label=RDM_ENC_CHB
PA9.Signal=S_TIM1_CH2
PB3.Signal=SYS_JTDO-SWO
PB6.GPIO_Label=MAG_SCL
PB6.Signal=I2C1_SCL
PB7.GPIO_Label=MAG_SDA
PB7.Signal=I2C1_SDA
PC13.GPIO_Label=MAG_INT
PC13.Signal=GPXTI13
PC14-OSC32_IN.GPIO_Label=ICM_INT
PC14-OSC32_IN.Signal=GPXTI14
PC15-OSC32_OUT.GPIO_Label=SBM_NSLEEP
PC15-OSC32_OUT.Signal=GPIO_Output
PC6.GPIO_Label=RDM_PWM_INA
PC6.Signal=S_TIM3_CH1
PC7.GPIO_Label=RDM_PWM_INB
PC7.Signal=S_TIM3_CH2
PC8.GPIO_Label=LDM_PWM_INA
PC8.Signal=S_TIM3_CH3
PC9.GPIO_Label=LDM_PWM_INB
PC9.Signal=S_TIM3_CH4
PH0-OSC_IN.Signal=RCC_OSC_IN
PH1-OSC_OUT.Signal=RCC_OSC_OUT
