thevinufernando/leo-floor-cleaning-robot/(commit log)

2026-07-16 Added the PCB design files
    [leo_BMS.SchDoc, leo_BMS_MCU.SchDoc, leo_DM_BUCK.SchDoc, leo_FLOORSEN.SchDoc, leo_IMU.SchDoc, leo_MCU.SchDoc, leo_MOTORS.SchDoc, leo_RPI_BUCK.SchDoc]
2026-07-16 Initialised the MCU firmware for main PCB
2026-07-17 Configured FreeRTOS, and added the firmware for IMU unit
2026-07-17 Did some adjustments to IMU driver files
2026-07-17 Added the ROS2 workspace and initialized it
    [base.xacro, cleaning_unit.xacro, cliff_sensors.xacro, common_properties.xacro, imu.xacro, lidar.xacro, robot.urdf.xacro]
2026-07-18 Initialised DM encoders from CubeMX
2026-07-18 Initialised motor encoders
2026-07-18 Configured drive motors with DRV8251A
2026-07-19 Configured MCU bridge and added slam config
    [common_properties.xacro]
2026-07-20 Finalized SLAM-mapping
    [common_properties.xacro]
2026-08-03 Fixed the queue element types issue (which cause the RPI-MCU bridge problem)
    [main.c, main_controller.ioc]
2026-08-03 Updated the PCB tests
2026-08-03 Updated the README file of PCB designs
2026-08-04 Add centrifugal pump design description
    Added a description for the centrifugal pump design, detailing its functionality and components.
2026-08-04 Centrifugal Pump Design
    The centrifugal pump is designed to transfer water by converting the rotational energy of an impeller into fluid pressure. It is driven by an A2212 1400KV brushless DC motor and fabricated using PLA through 3D printing. Water enters through the central inlet and exits through the outlet under increased pressure.
    [vaccum with base.iges, vaccum with base.step]
2026-08-04 centrifugal pump design Files
    This folder contains the mechanical design files for the centrifugal pump used in the LEO Floor Cleaning Robot.
    [impeller_01.SLDPRT, impeller_02.SLDPRT, vaccum with base with motor.SLDASM, vaccum with base.iges, vaccum with base.step, vaccum with impeller.STEP]
2026-08-06 Update centrifugal pump SolidWorks files
    [Centrifugal_Pump_Case2.SLDPRT, support.SLDPRT, vaccum with base.iges, vaccum with base.step, vaccum.SLDASM, vaccum.STEP]
