thevinufernando/leo-floor-cleaning-robot/(notices)

Notices in the files:
mcu_firmware/main_controller/Core/Src/main.c:
Copyright (c) 2026 STMicroelectronics.
All rights reserved.
This software is licensed under terms that can be found in the LICENSE file
